jemdiggity/nami/hardware/nami-compact/exports/routing-review.pdf

## Crystal

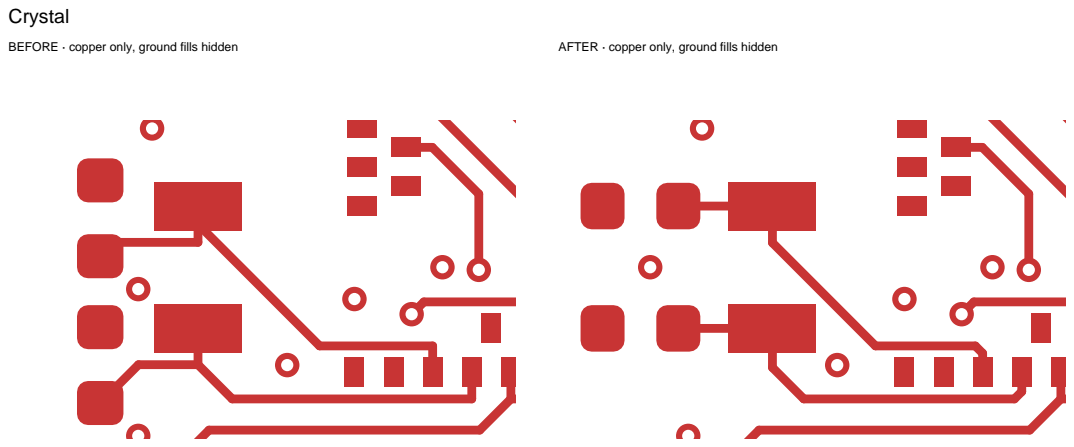
[picture p4: page 1]
BEFORE · copper only, ground fills hidden; AFTER · copper only, ground fills hidden

## Module supply

BEFORE · copper only, ground fills hidden | AFTER · copper only, ground fills hidden

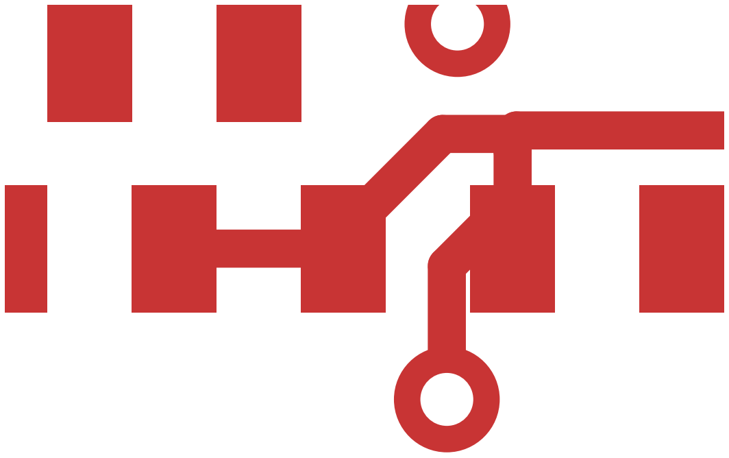
[picture p5: figure]
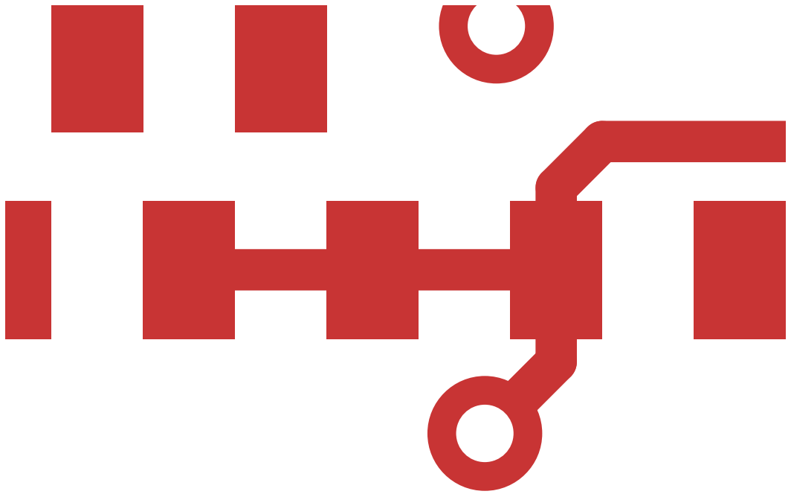
[picture p6: figure]

## CT return

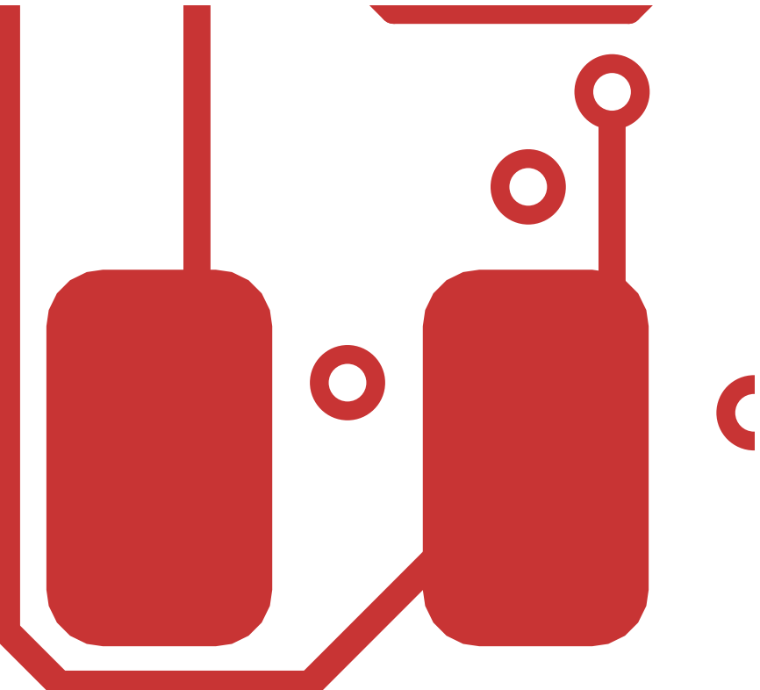
[picture p7: figure]
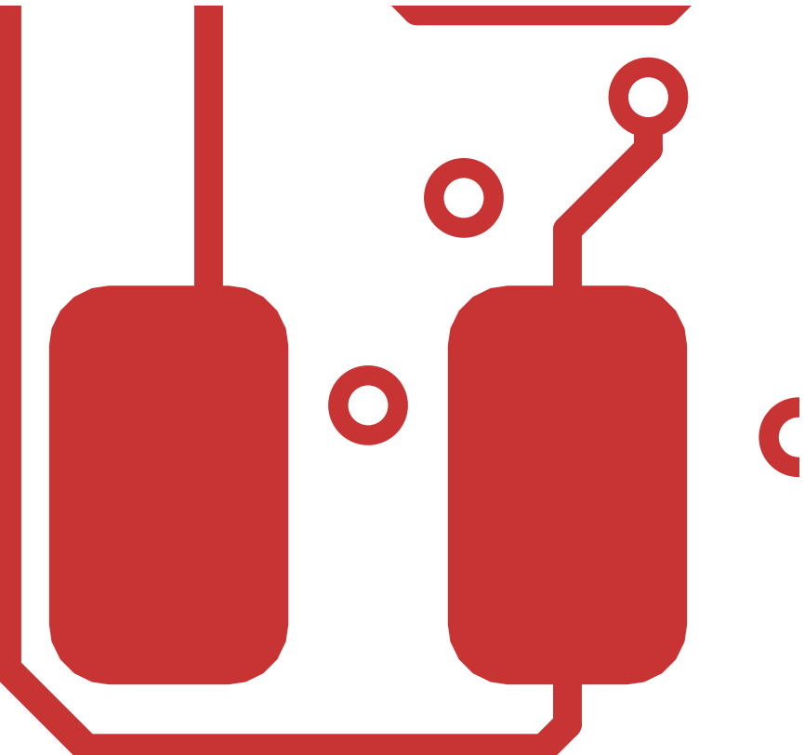
[picture p8: figure]

BEFORE · copper only, ground fills hidden | AFTER · copper only, ground fills hidden

## Module signals

BEFORE · copper only, ground fills hidden | AFTER · copper only, ground fills hidden

## Supply capacitor

BEFORE · copper only, ground fills hidden | AFTER · copper only, ground fills hidden

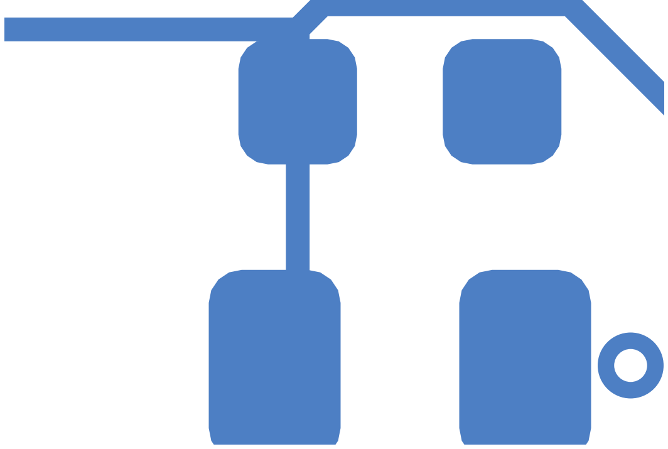
[picture p9: figure]
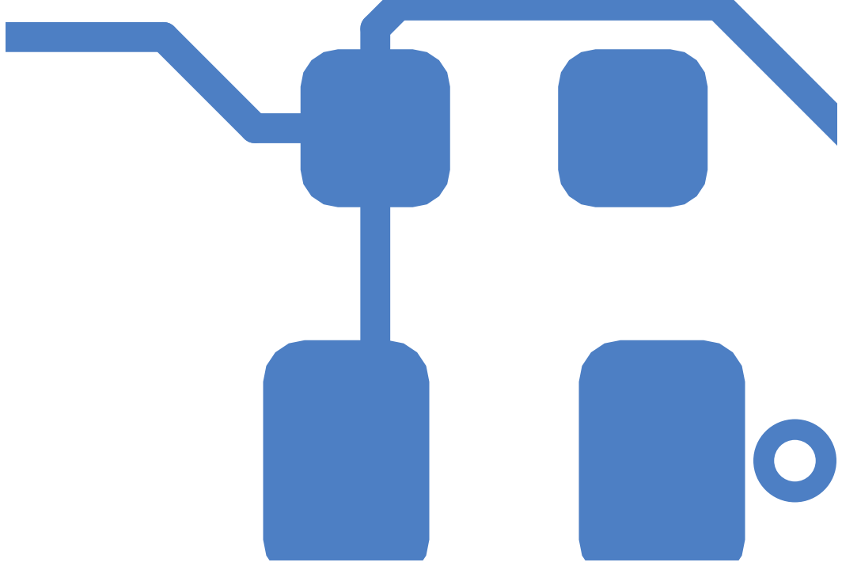
[picture p10: figure]

## Flash MOSI

BEFORE · copper only, ground fills hidden | AFTER · copper only, ground fills hidden

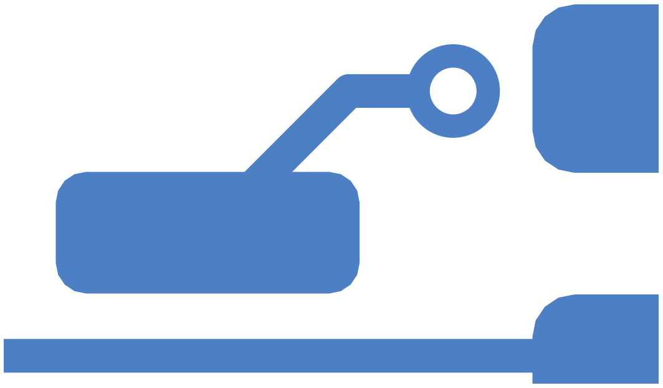
[picture p11: figure]
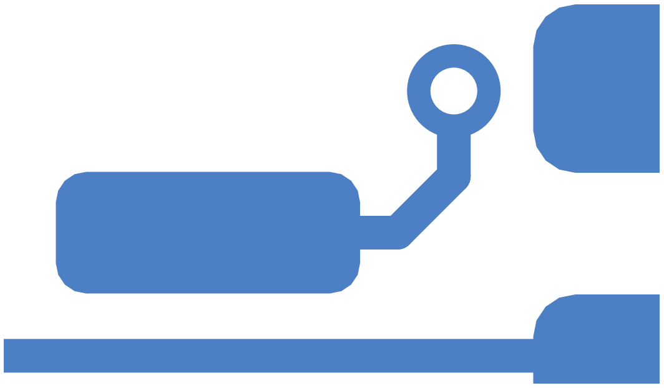
[picture p12: figure]

## Power links

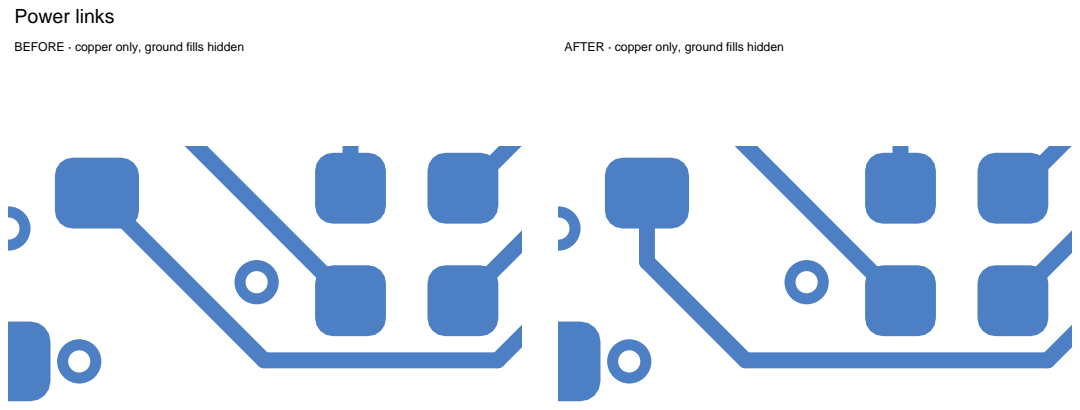
[picture p13: page 7]
BEFORE · copper only, ground fills hidden; AFTER · copper only, ground fills hidden

## Flash clock

BEFORE · copper only, ground fills hidden | AFTER · copper only, ground fills hidden

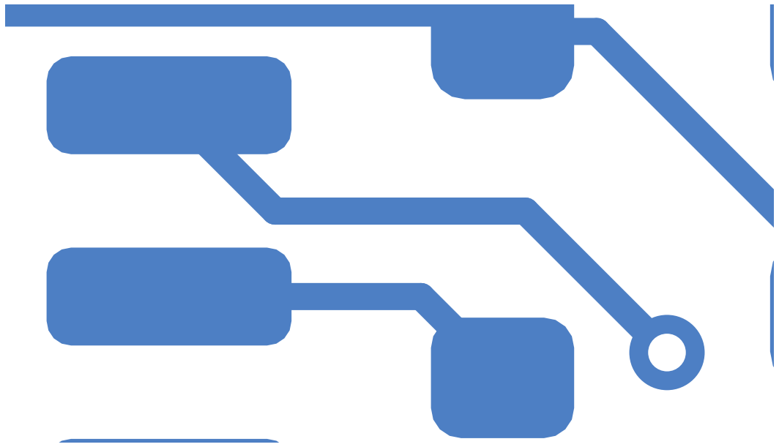
[picture p14: figure]
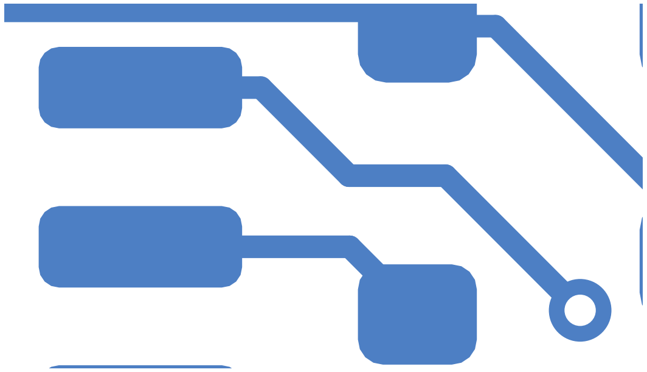
[picture p15: figure]

## Battery feed

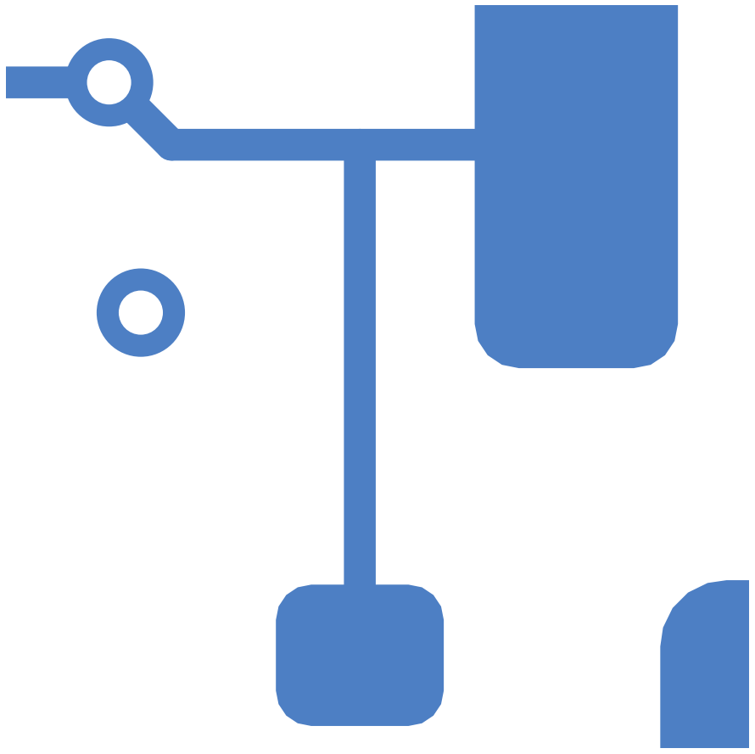
[picture p16: figure]
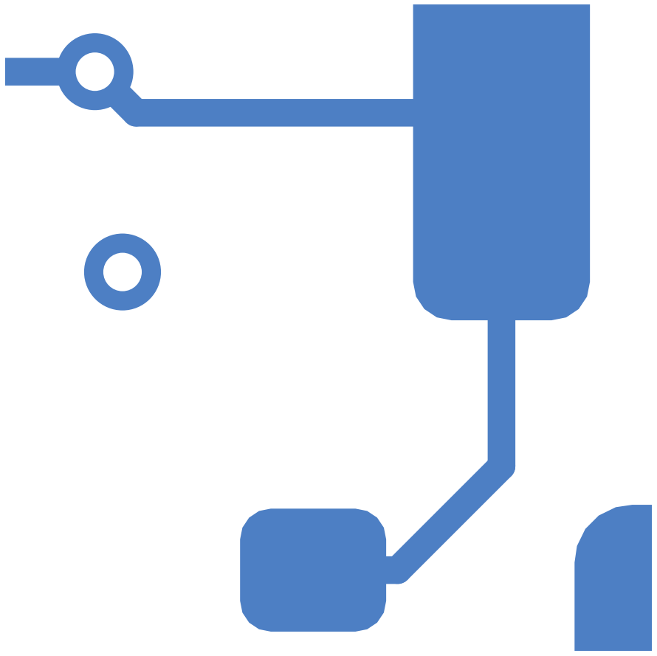
[picture p17: figure]

BEFORE · copper only, ground fills hidden | AFTER · copper only, ground fills hidden

## Power link R7

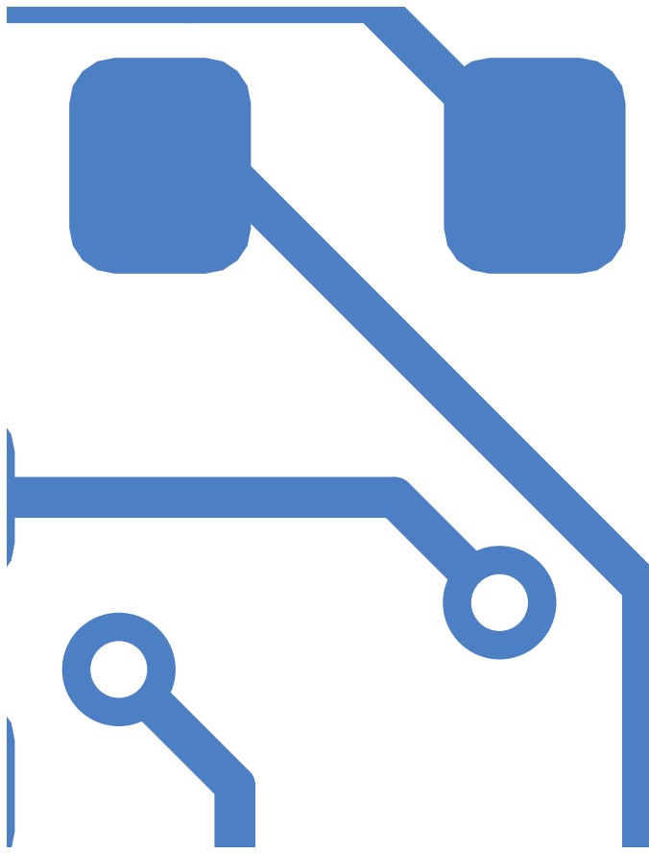
[picture p18: figure]
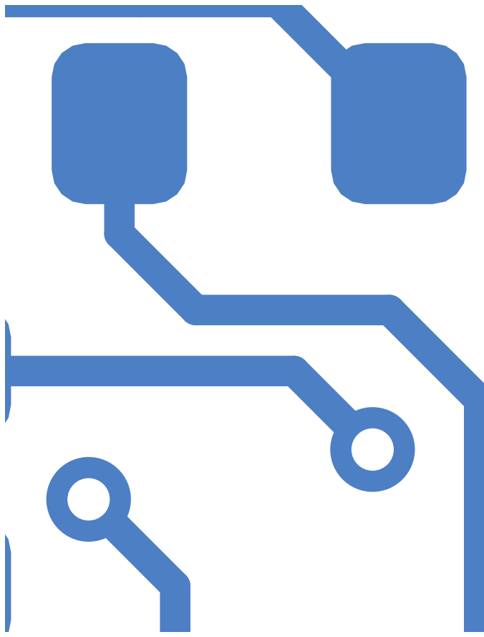
[picture p19: figure]

BEFORE · copper only, ground fills hidden | AFTER · copper only, ground fills hidden
