jemdiggity/nami/hardware/nami-rev-a/exports/nami-board.png

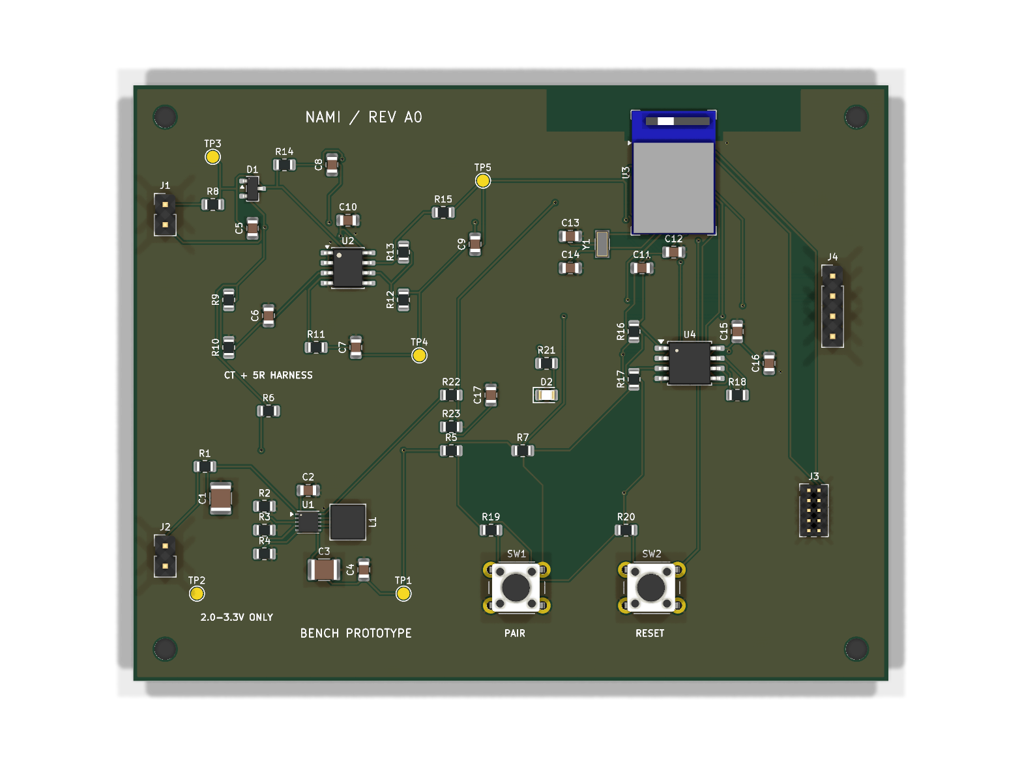
hardware/nami-rev-a/exports/nami-board.png
