jemdiggity/nami/hardware/nami-compact/exports/nami-compact.step

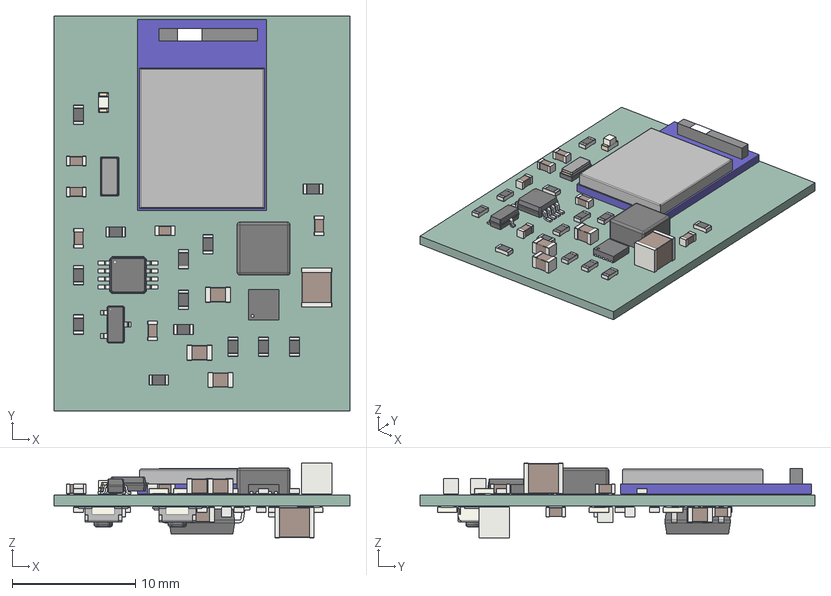
[picture p21: CAD file, 2026-09-26]
hardware/nami-compact/exports/nami-compact.step
24.0 x 32.0 x 6.08 mm
C_0603_1608Metric x 10
R_0603_1608Metric x 23
VSSOP-8_3x3mm_P0.65mm
LED_0603_1608Metric
SOT-23
C_0805_2012Metric x 5
Crystal_SMD_3215-2Pin_3.2x1.5mm
C_1210_3225Metric x 2
7a0a93aa-926b-11ed-8620-a0cec80452fd_part
7a0a9878-926b-11ed-8620-a0cec80452fd_part
7a0a9b48-926b-11ed-8620-a0cec80452fd_part
7a0a9db4-926b-11ed-8620-a0cec80452fd_part
Raytac_MDBT50Q
L_Coilcraft_XAL4020-XXX
SW_SPST_B3U-1000P x 2
SOIC-8_5.3x5.3mm_P1.27mm
nami_PCB
