jemdiggity/nami/(list of files, cad)

Other CAD files:
hardware/nami-compact/exports/nami-compact.stl
