jemdiggity/nami/hardware/nami-rev-a/exports/nami-schematic.pdf

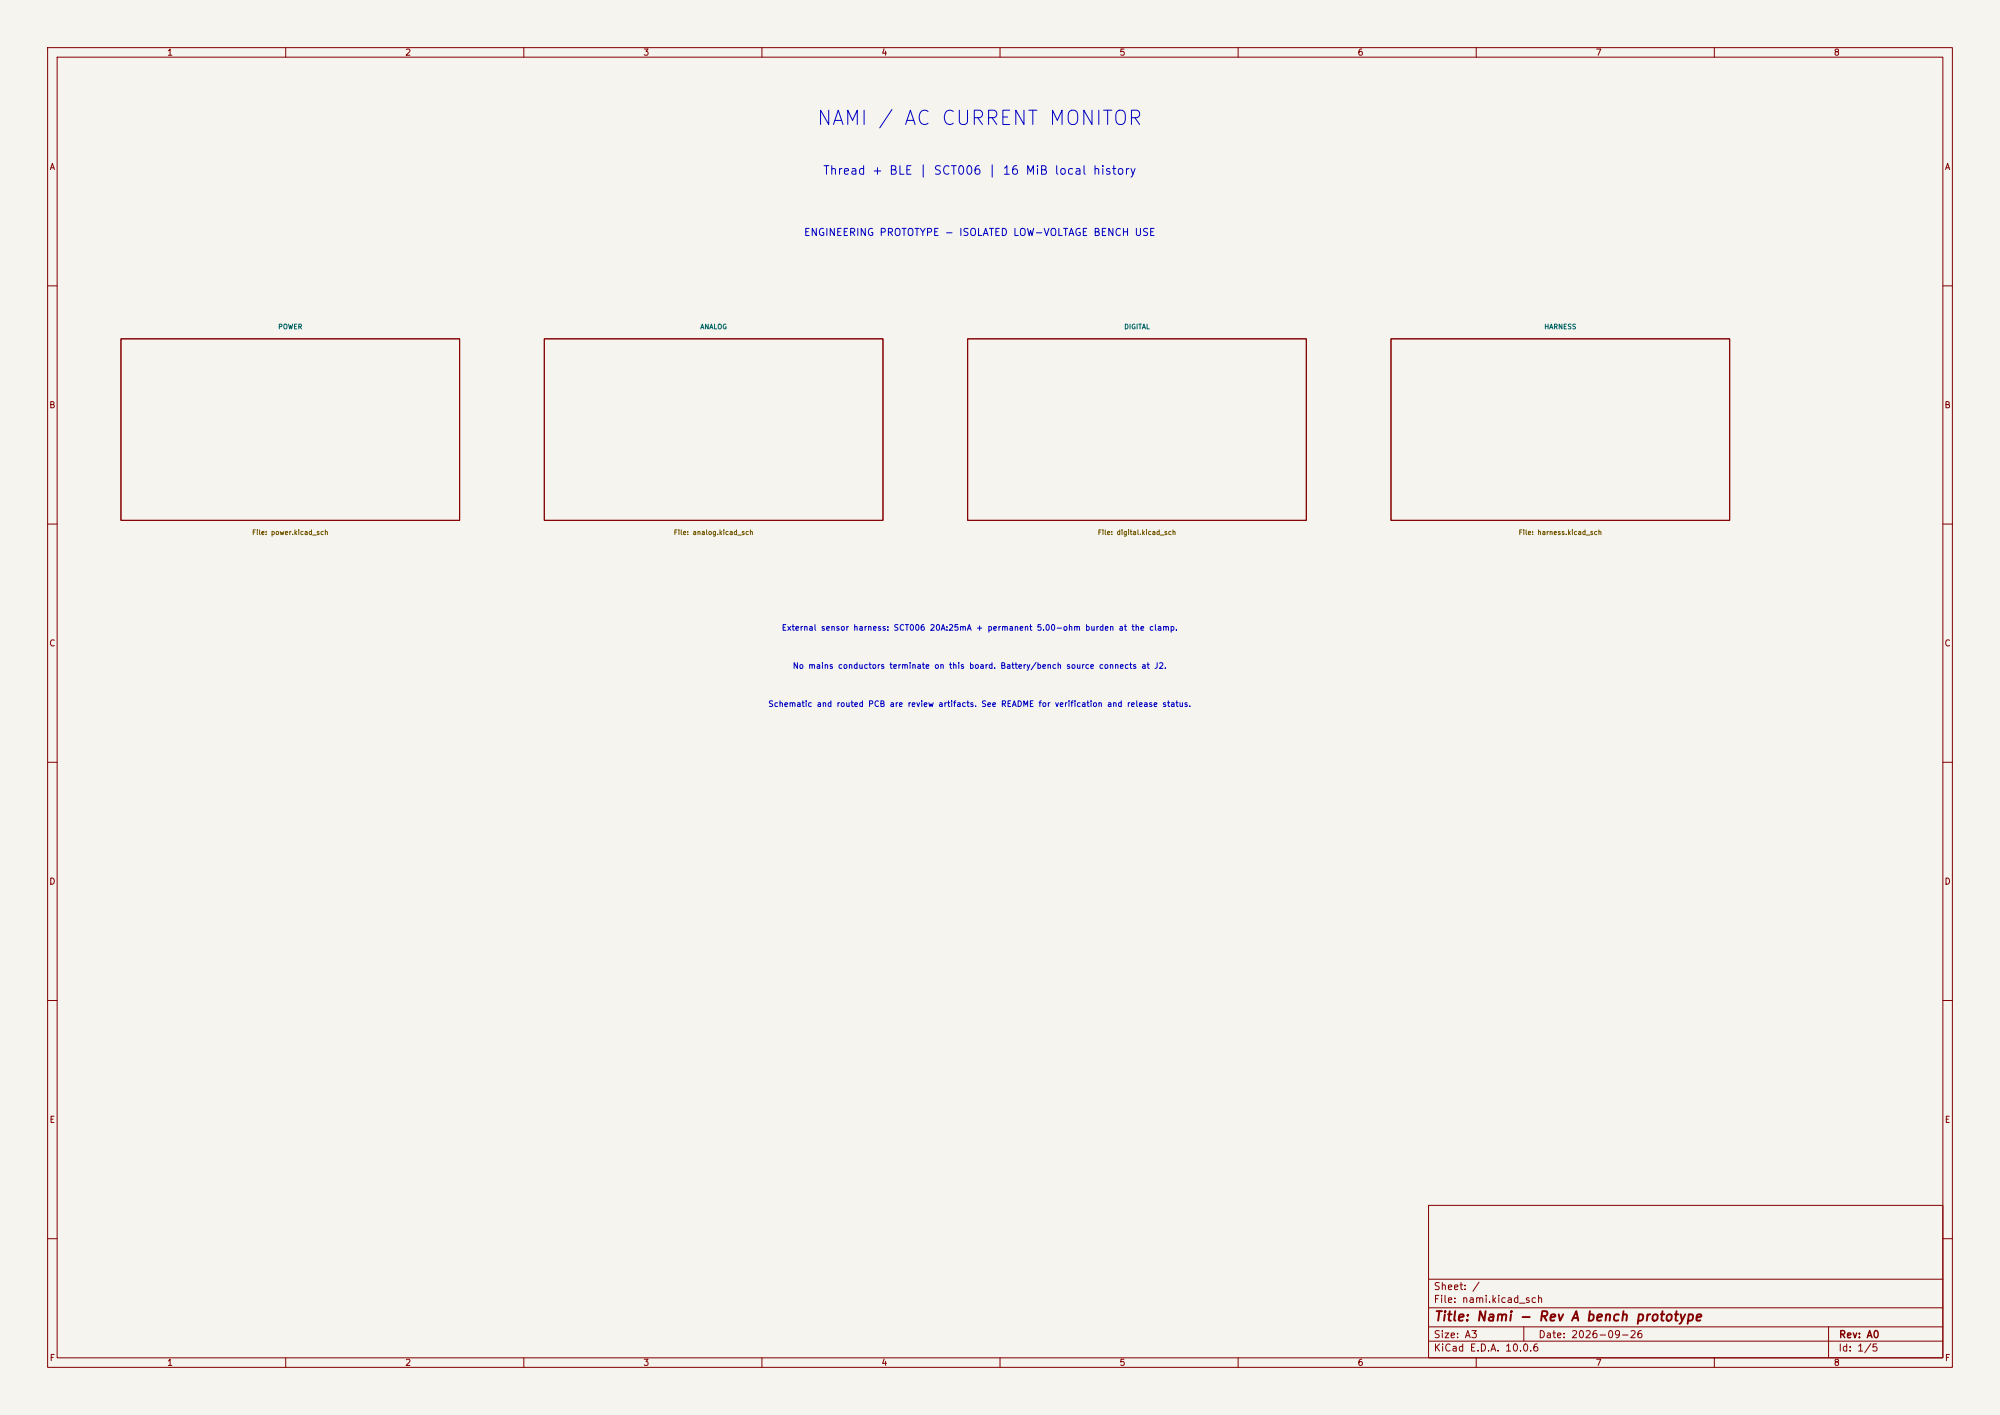
[picture p27: page 1]

File: harness.kicad_sch NAMI / AC CURRENT MONITOR

Thread + BLE | SCT006 | 16 MiB local history

ENGINEERING PROTOTYPE - ISOLATED LOW-VOLTAGE BENCH USE

External sensor harness: SCT006 20A:25mA + permanent 5.00-ohm burden at the clamp. No mains conductors terminate on this board. Battery/bench source connects at J2. Schematic and routed PCB are review artifacts. See README for verification and release status.

Sheet: /
File: nami.kicad_sch
Title: Nami - Rev A bench prototype

Size: A3 | Rev: A0 | F Date: 2026-09-26
KiCad E.D.A. 10.0.6 | Id: 1/5

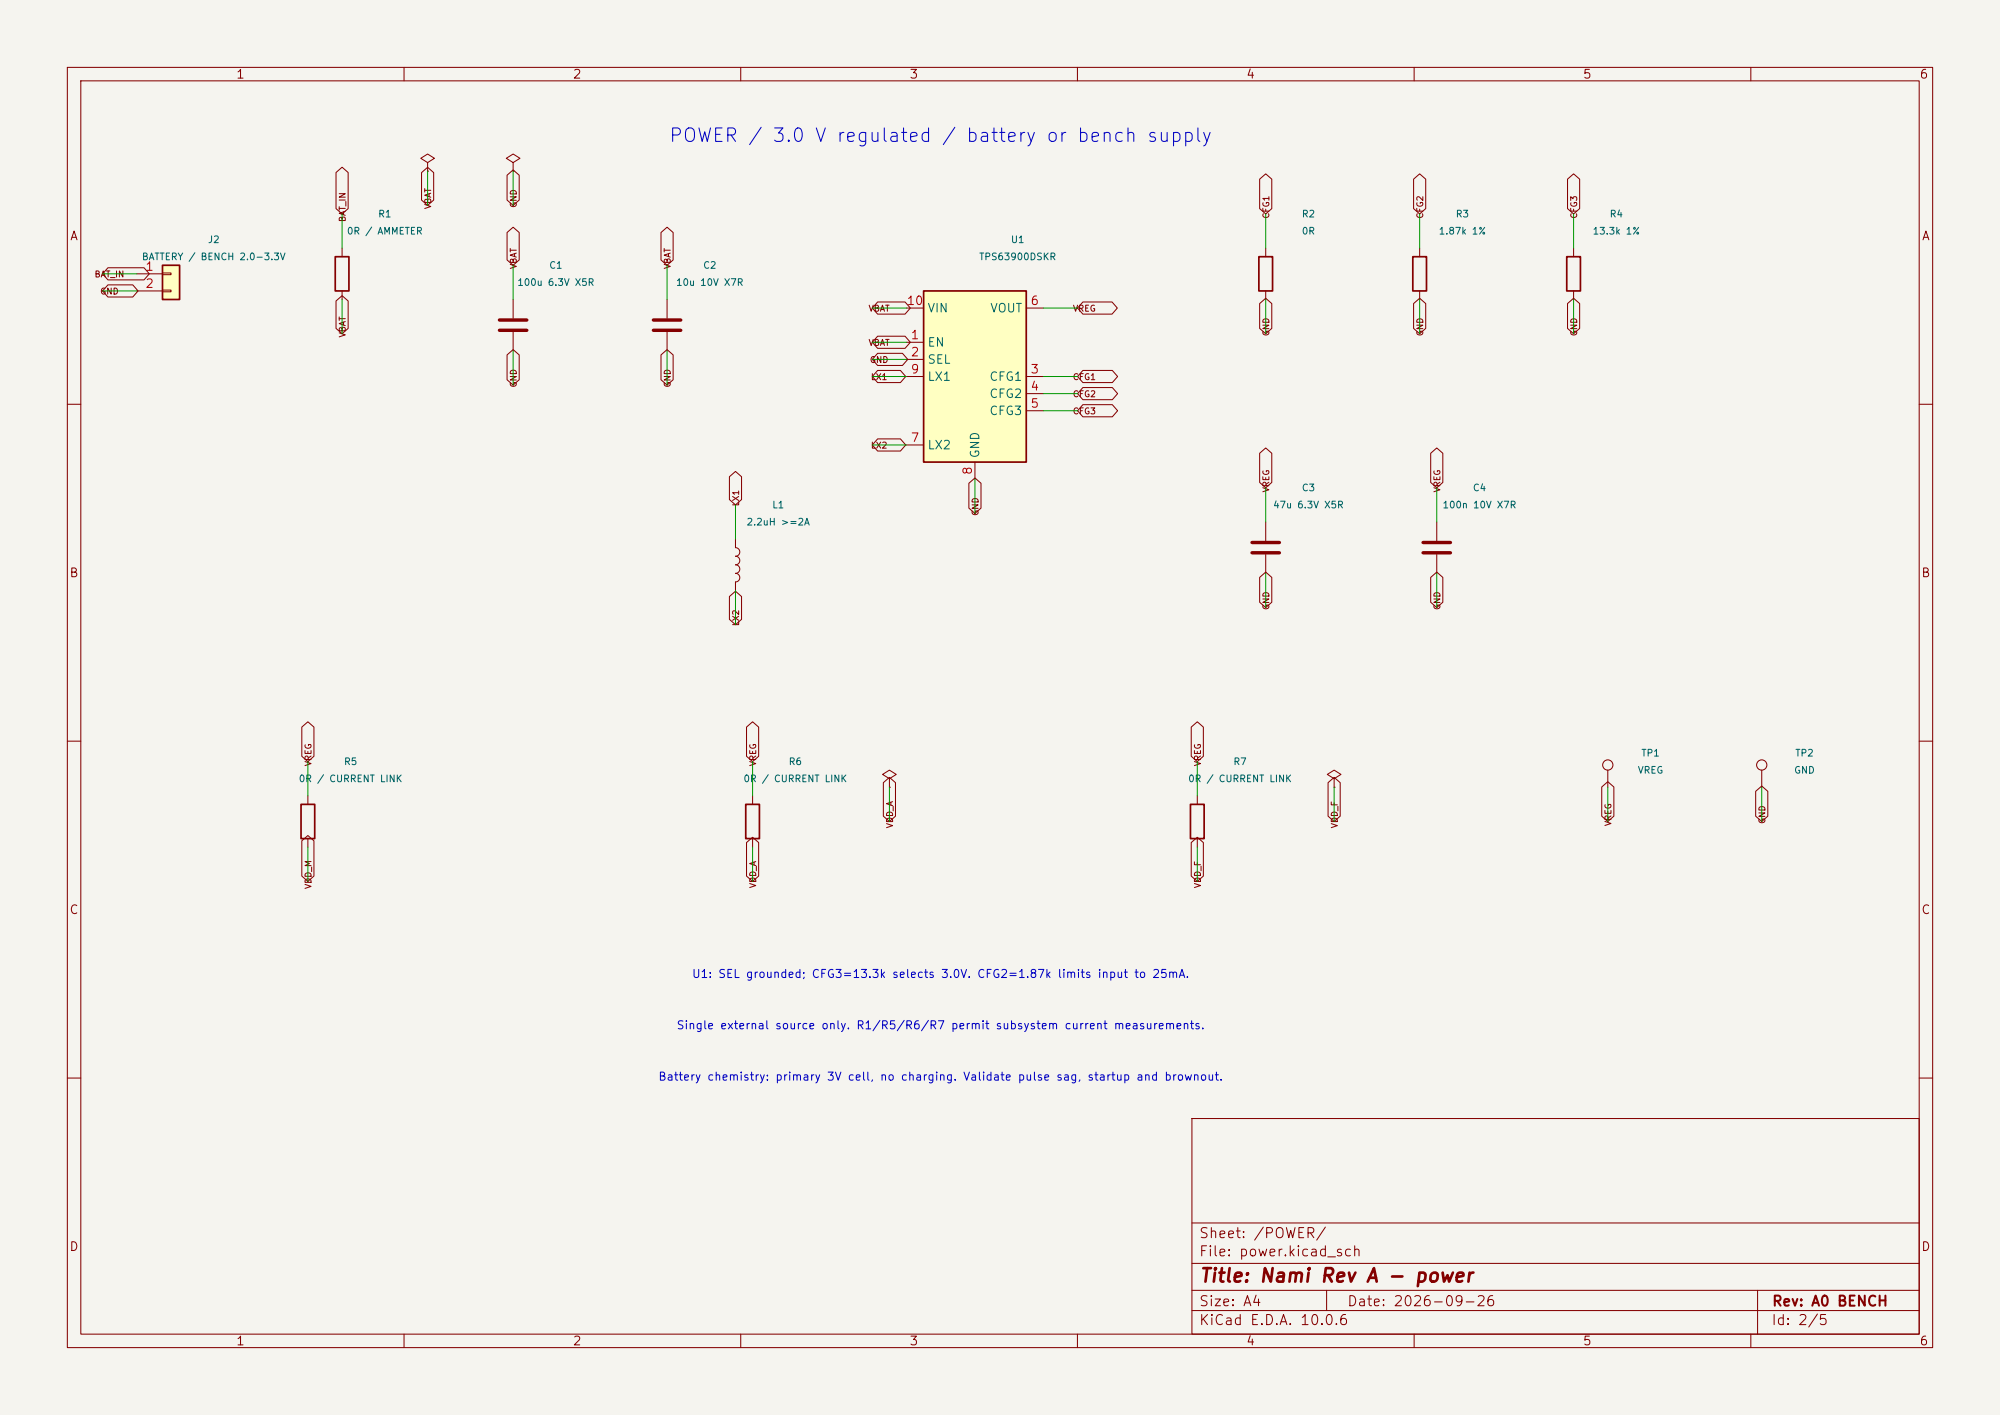
[picture p28: page 2]

POWER / 3.0 V regulated / battery or bench supply

Sheet: /POWER/
File: power.kicad_sch
Title: Nami Rev A - power

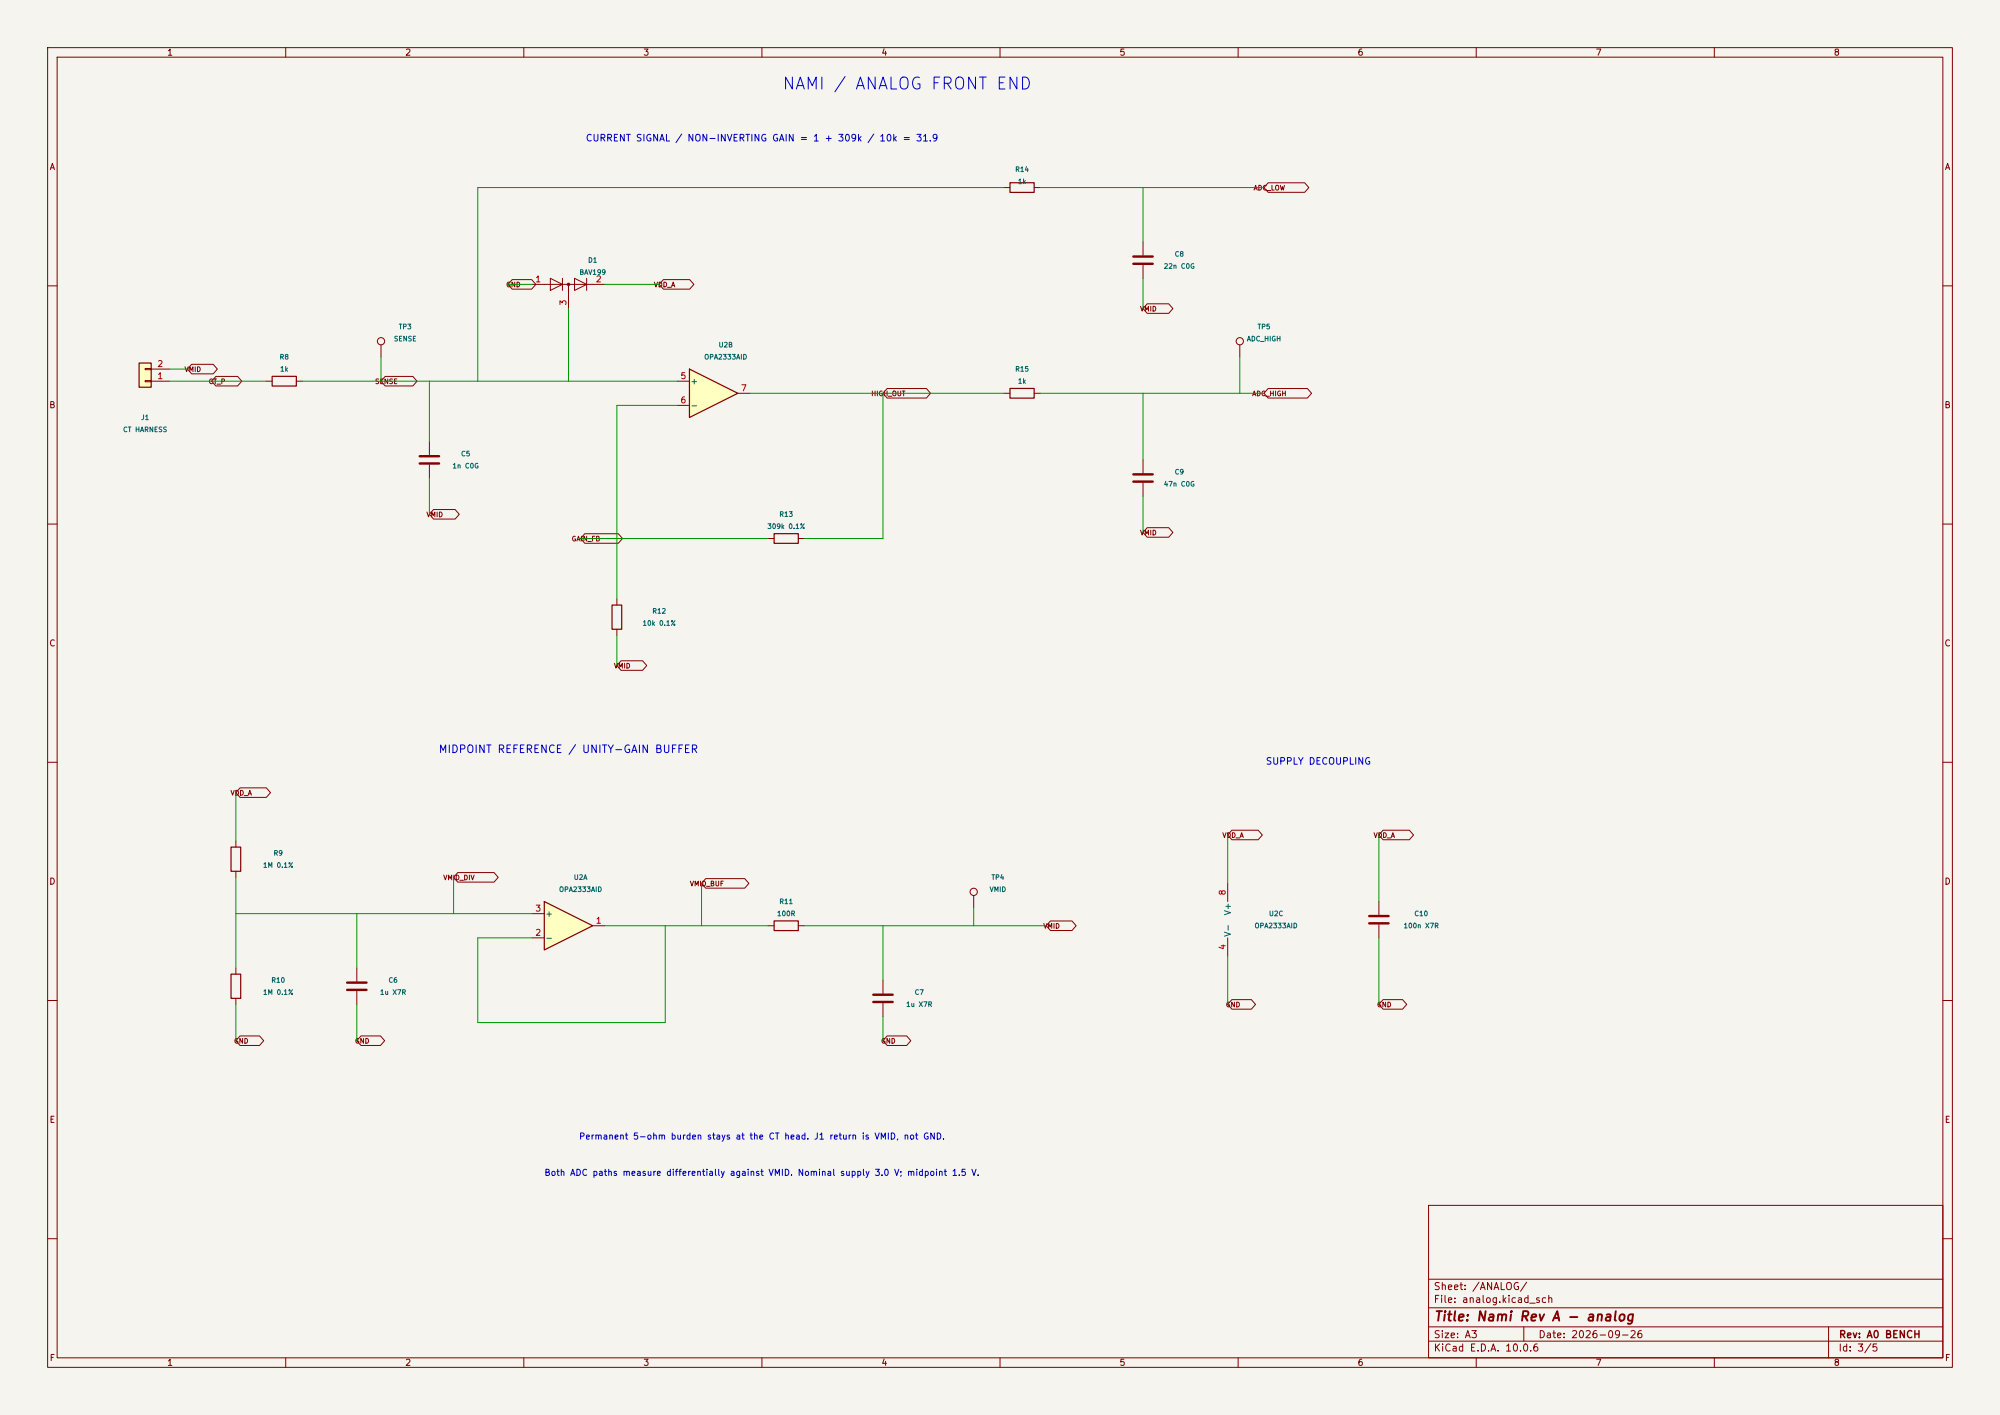
[picture p29: page 3]

VMID CURRENT SIGNAL / NON-INVERTING GAIN = 1 + 309k / 10k = 31.9 NAMI / ANALOG FRONT END
U2B OPA2333AID 1 -

Both ADC paths measure differentially against VMID. Nominal supply 3.0 V; midpoint 1.5 V. Permanent 5-ohm burden stays at the CT head. J1 return is VMID, not GND. MIDPOINT REFERENCE / UNITY-GAIN BUFFER

Sheet: /ANALOG/
File: analog.kicad_sch
Title: Nami Rev A - analog

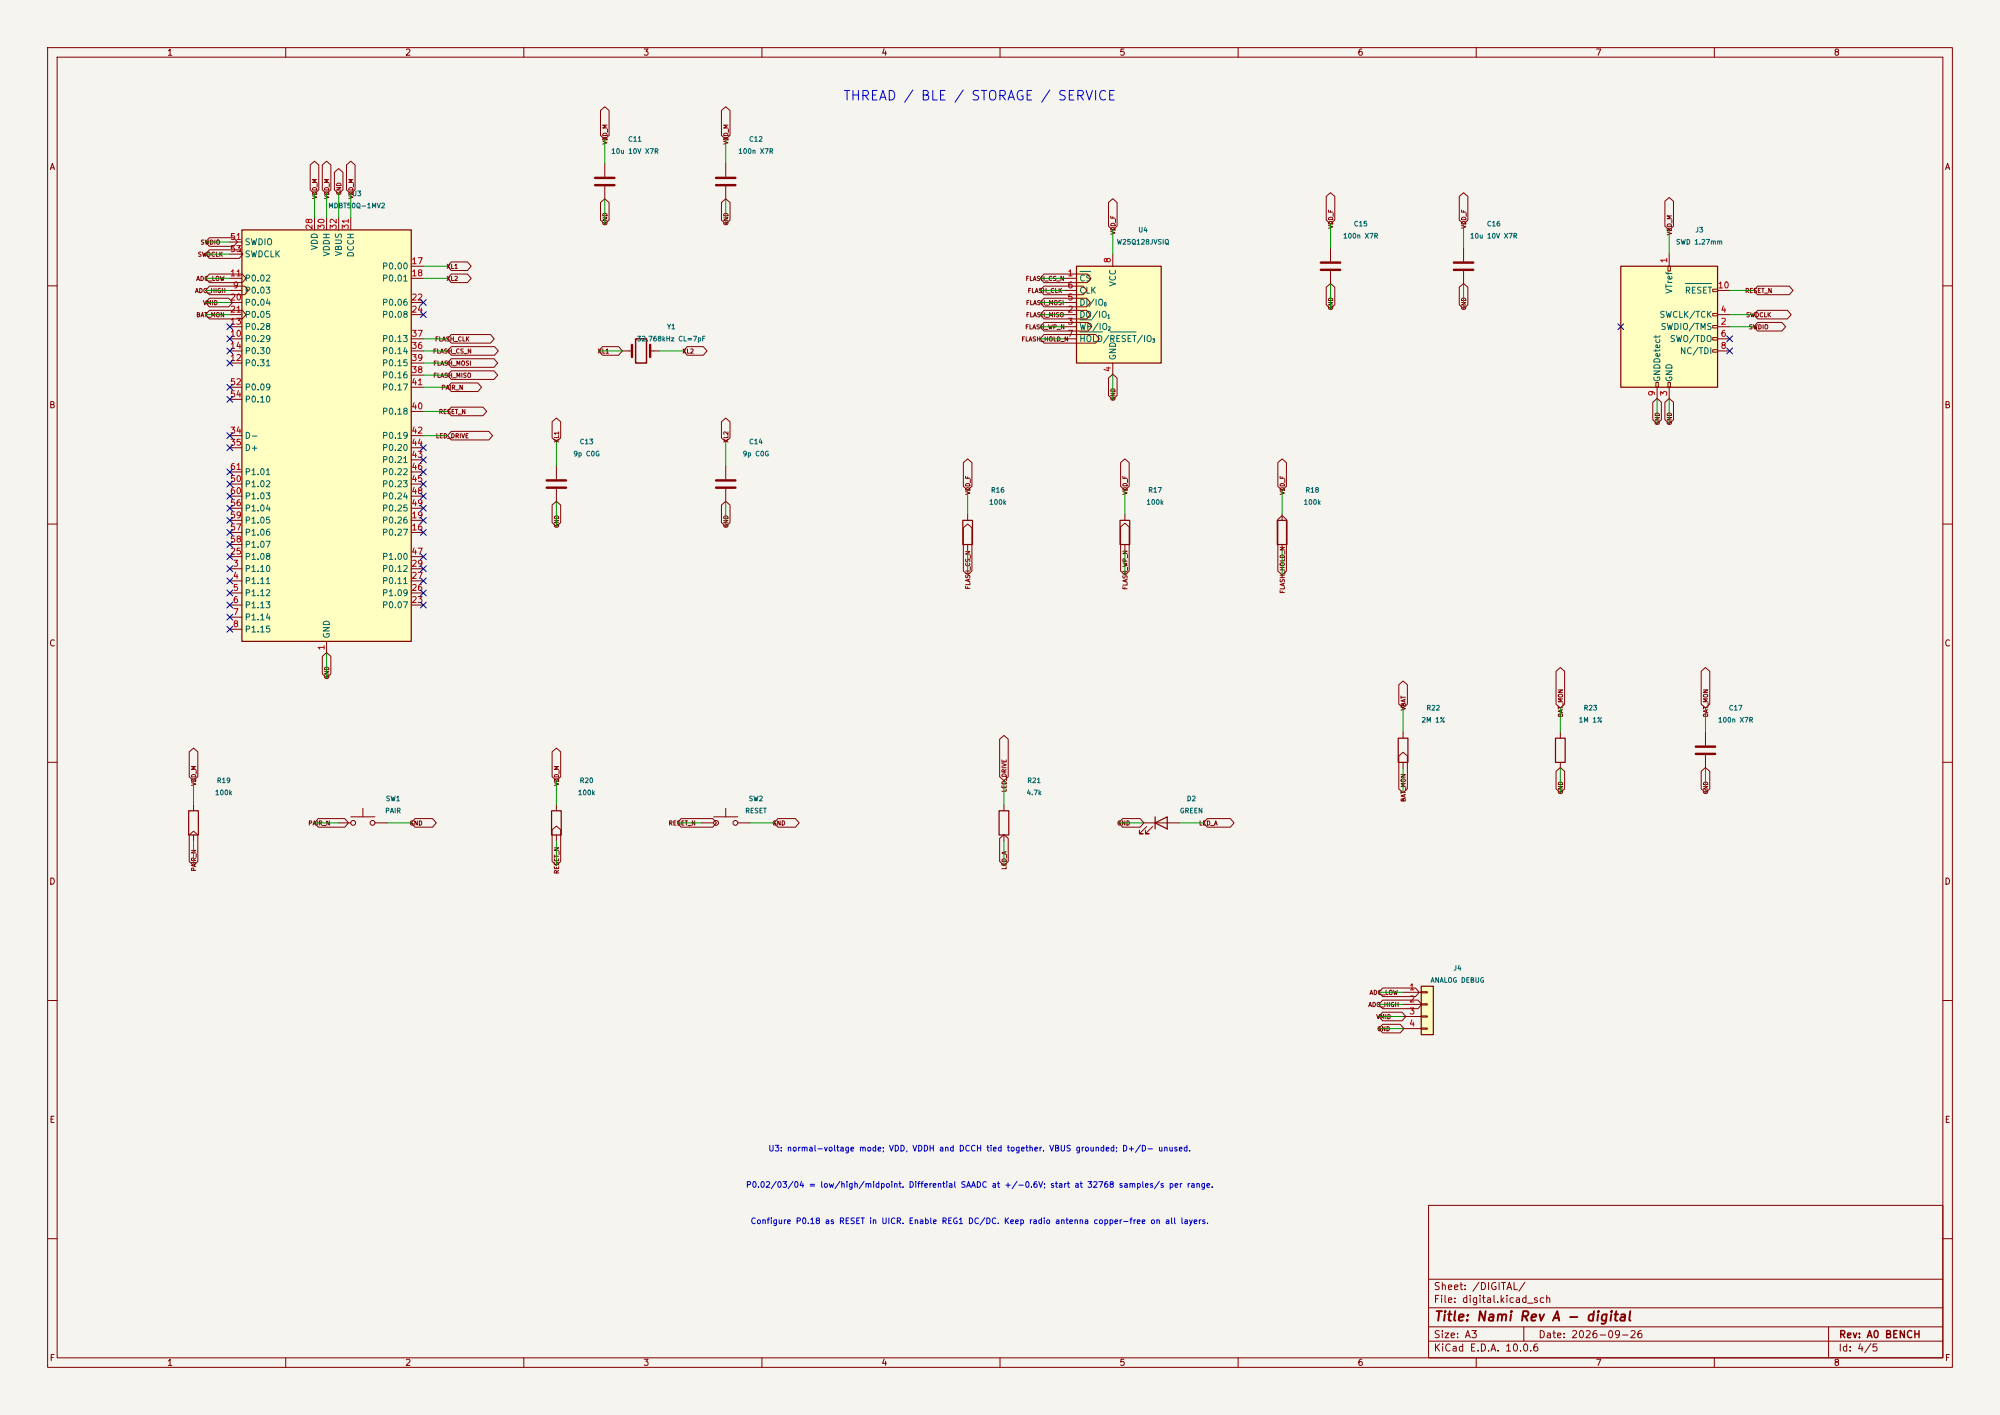
[picture p30: page 4]

THREAD / BLE / STORAGE / SERVICE

1 P1.10 3 P1.11 4 P1.12 5 P1.13 6 P1.14 7 P1.15 8 P0.03 9 P0.29 10 P0.02 11 P0.31 12 P0.28 13 P0.30 14 P0.27 16 P0.00 17 P0.01 18 P0.26 19 P0.04 20 P0.05 21 P0.06 22 P0.07 23 P0.08 24 P1.08 25 P1.09 26 P0.11 27 VDD 28 P0.12 29 VDDH 30 DCCH 31 VBUS 32 D- 34 D+ 35 P0.14 36 P0.13 37 P0.16 38 P0.15 39 P0.18 40 P0.17 41 P0.19 42 P0.21 43 P0.20 44 P0.23 45 P0.22 46 P1.00 47 P0.24 48 P0.25 49 P1.02 50

4 DI/IO0 5 CLK 6 HOLD/RESET/IO3 7 VCC

P0.02/03/04 = low/high/midpoint. Differential SAADC at +/-0.6V; start at 32768 samples/s per range.

Sheet: /DIGITAL/
File: digital.kicad_sch
Title: Nami Rev A - digital

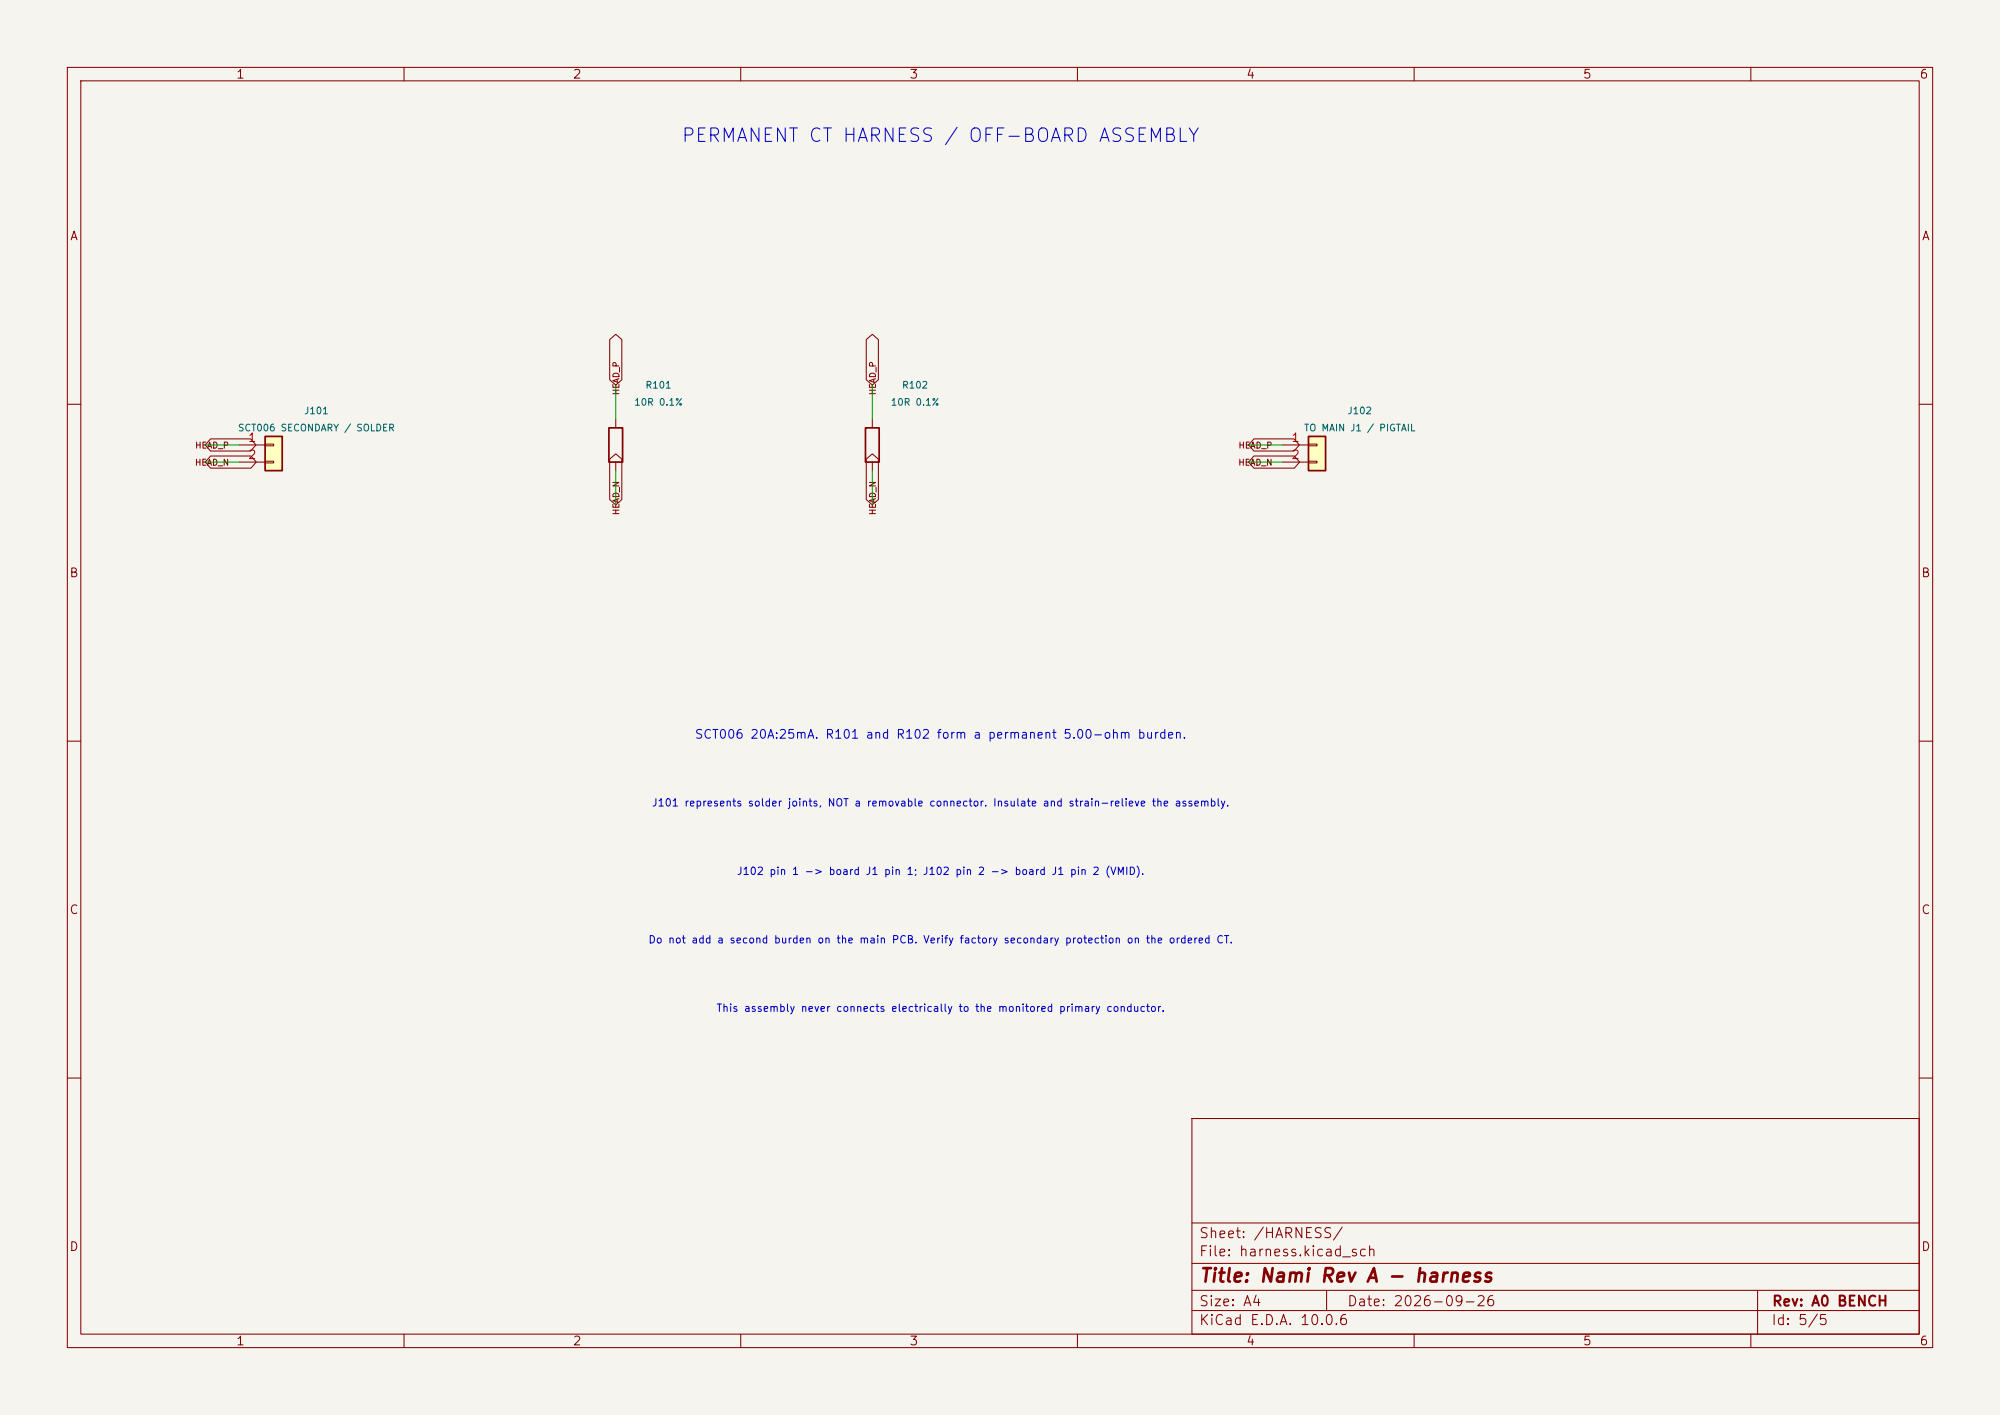
[picture p31: page 5]

This assembly never connects electrically to the monitored primary conductor. Do not add a second burden on the main PCB. Verify factory secondary protection on the ordered CT. J102 pin 1 -> board J1 pin 1; J102 pin 2 -> board J1 pin 2 (VMID). J101 represents solder joints, NOT a removable connector. Insulate and strain-relieve the assembly. SCT006 20A:25mA. R101 and R102 form a permanent 5.00-ohm burden.

Sheet: /HARNESS/
File: harness.kicad_sch
Title: Nami Rev A - harness
