jemdiggity/nami/hardware/nami-compact/nami.kicad_pcb

## KiCad design hardware/nami-compact/nami.kicad_pcb (2026-09-26)

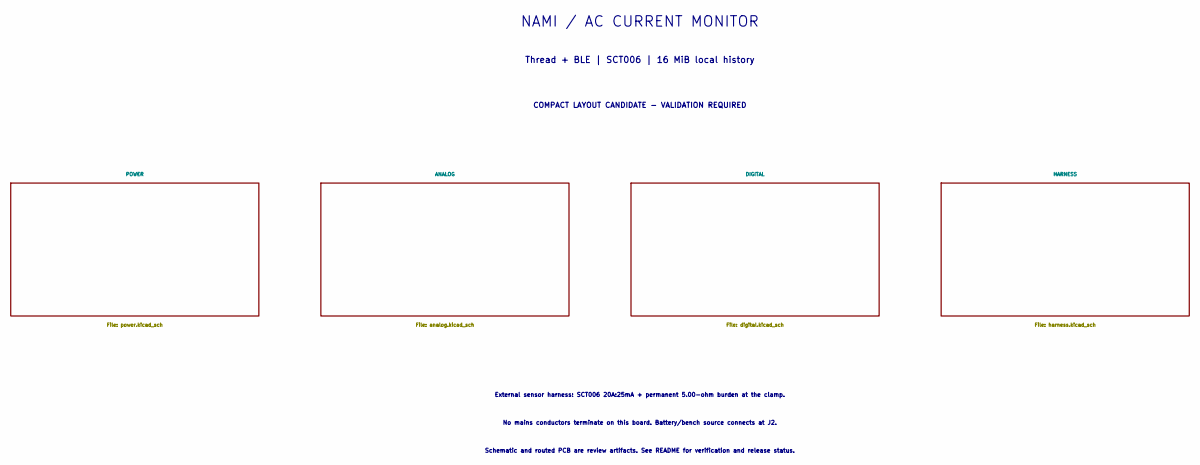
[picture p32: schematic nami.kicad_sch, Nami Compact C0]

Notes on the sheet:
NAMI / AC CURRENT MONITOR
Thread + BLE | SCT006 | 16 MiB local history
COMPACT LAYOUT CANDIDATE - VALIDATION REQUIRED
External sensor harness: SCT006 20A:25mA + permanent 5.00-ohm burden at the clamp.
No mains conductors terminate on this board. Battery/bench source connects at J2.
Schematic and routed PCB are review artifacts. See README for verification and release status.

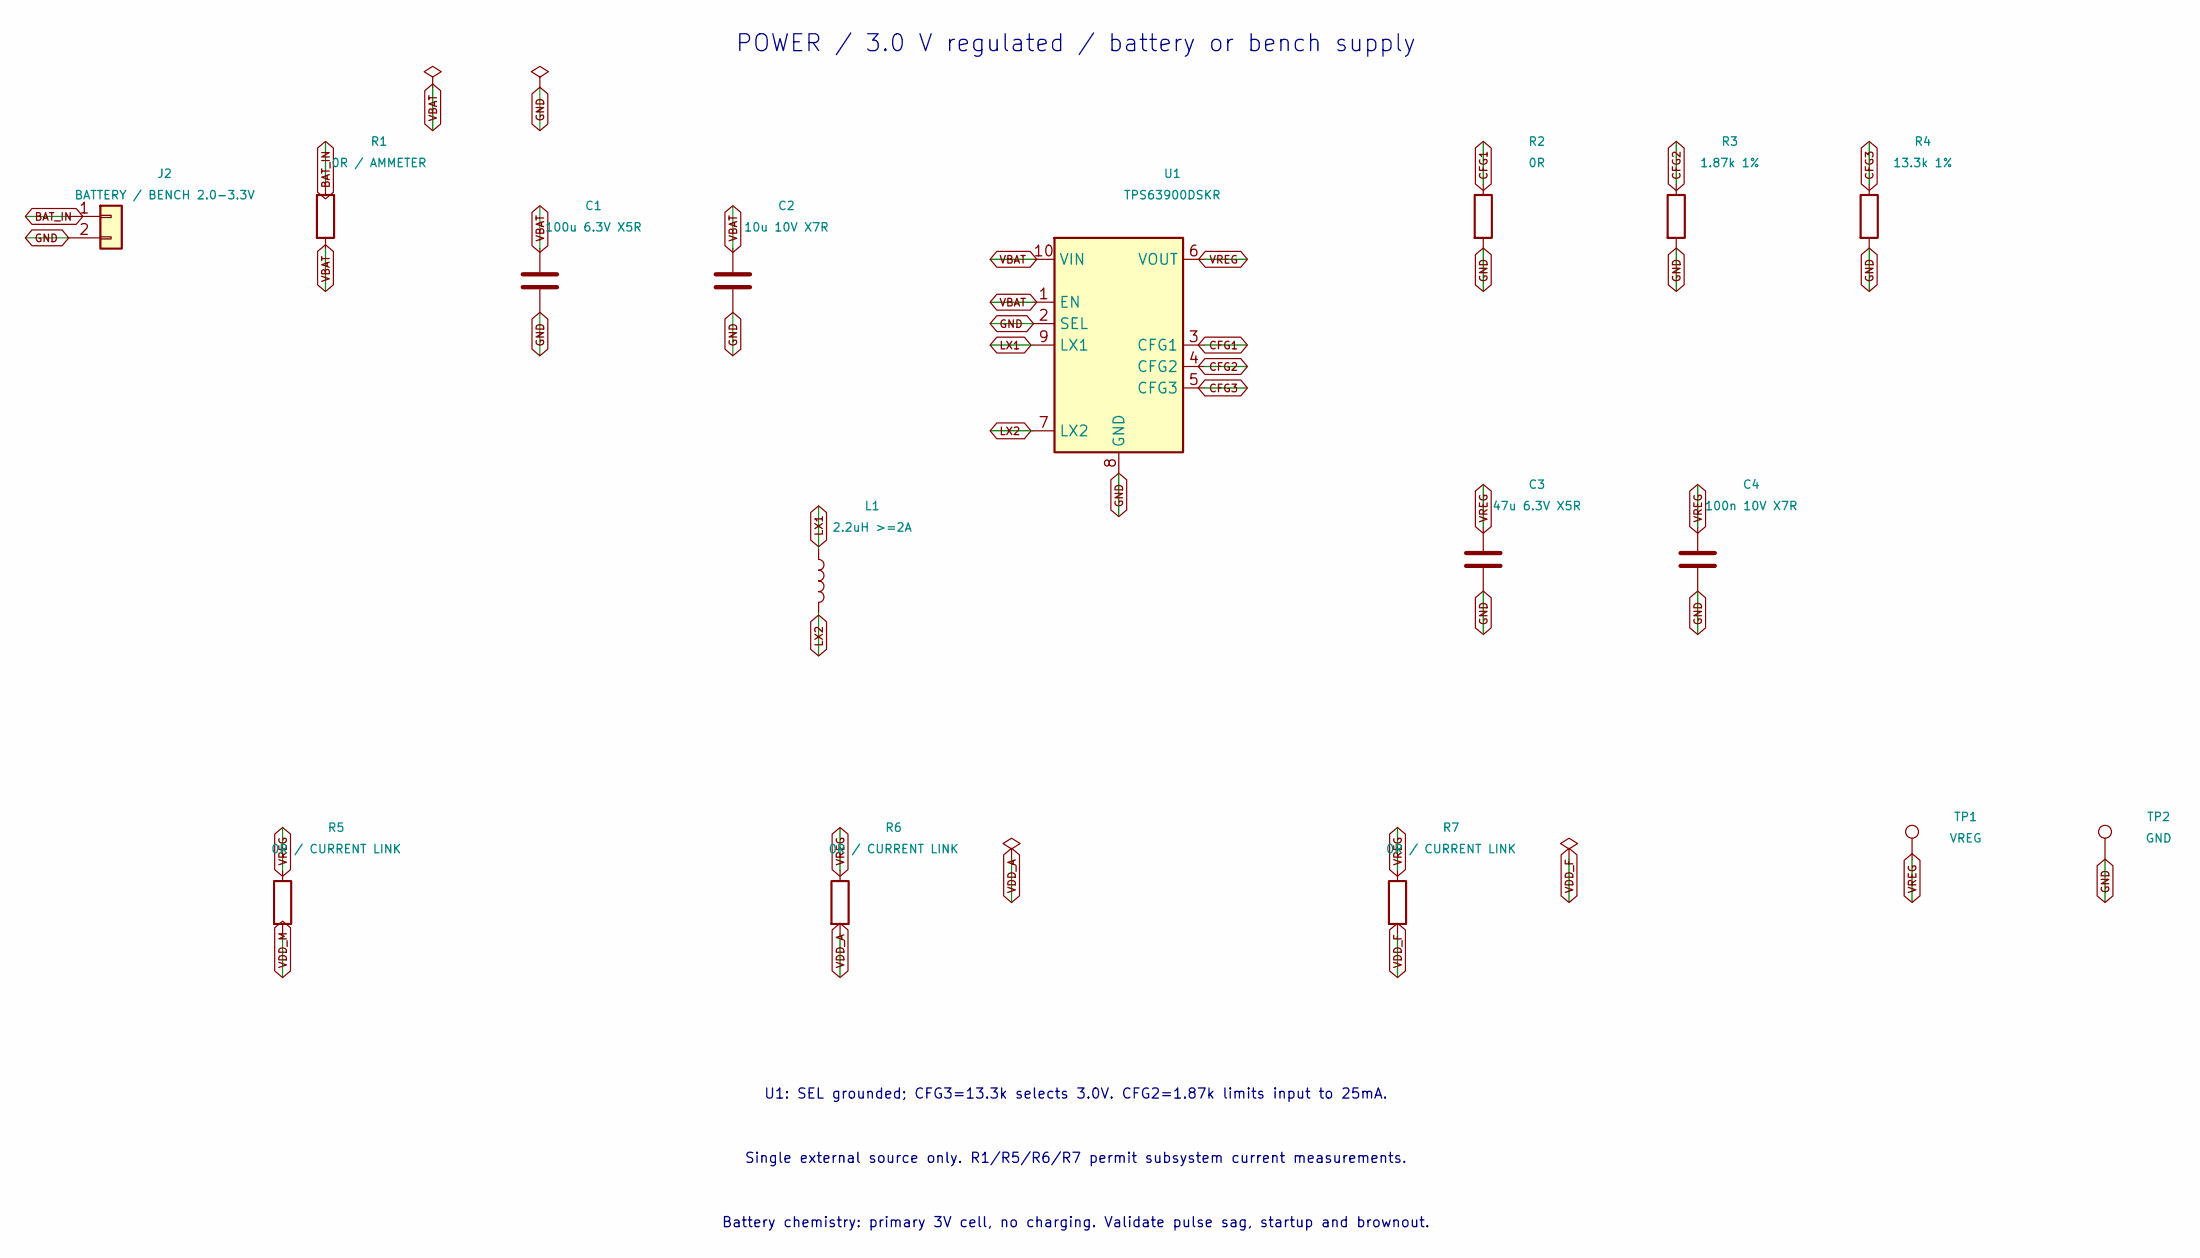
[picture p33: schematic power.kicad_sch, Nami Compact C0 - power]

Parts:
C1: 100u 6.3V X5R; C_1210_3225Metric; MPN GRM32ER60J107ME20L
C2: 10u 10V X7R; C_0805_2012Metric
C3: 47u 6.3V X5R; C_1210_3225Metric
C4: 100n 10V X7R; C_0603_1608Metric
J2: BATTERY / BENCH 2.0-3.3V; WirePads_2_P2.5
L1: 2.2uH >=2A; L_Coilcraft_XAL4020-XXX; MPN XAL4020-222MEC
R1: 0R / AMMETER; R_0603_1608Metric
R2: 0R; R_0603_1608Metric
R3: 1.87k 1%; R_0603_1608Metric
R4: 13.3k 1%; R_0603_1608Metric
R5, R6, R7: 0R / CURRENT LINK; R_0603_1608Metric
TP1: VREG; TestPoint_Pad_D1.0mm
TP2: GND; TestPoint_Pad_D1.0mm
U1: TPS63900DSKR; WSON-10-1EP_2.5x2.5mm_P0.5mm_EP1.2x2mm; MPN TPS63900DSKR

Connections:
BAT_IN: J2.1, R1.1
CFG1: R2.1, U1.3 (CFG1)
CFG2: R3.1, U1.4 (CFG2)
CFG3: R4.1, U1.5 (CFG3)
GND: C1.2, C2.2, C3.2, C4.2, J2.2, R2.2, R3.2, R4.2, TP2.1, U1.2 (SEL), U1.8 (GND), U1.11 (GND); also elsewhere on the board
LX1: L1.1, U1.9 (LX1)
LX2: L1.2, U1.7 (LX2)
VBAT: C1.1, C2.1, R1.2, U1.1 (EN), U1.10 (VIN); also elsewhere on the board
VDD_A: R6.2; also elsewhere on the board
VDD_F: R7.2; also elsewhere on the board
VDD_M: R5.2; also elsewhere on the board
VREG: C3.1, C4.1, R5.1, R6.1, R7.1, TP1.1, U1.6 (VOUT)

Notes on the sheet:
POWER / 3.0 V regulated / battery or bench supply
U1: SEL grounded; CFG3=13.3k selects 3.0V. CFG2=1.87k limits input to 25mA.
Single external source only. R1/R5/R6/R7 permit subsystem current measurements.
Battery chemistry: primary 3V cell, no charging. Validate pulse sag, startup and brownout.

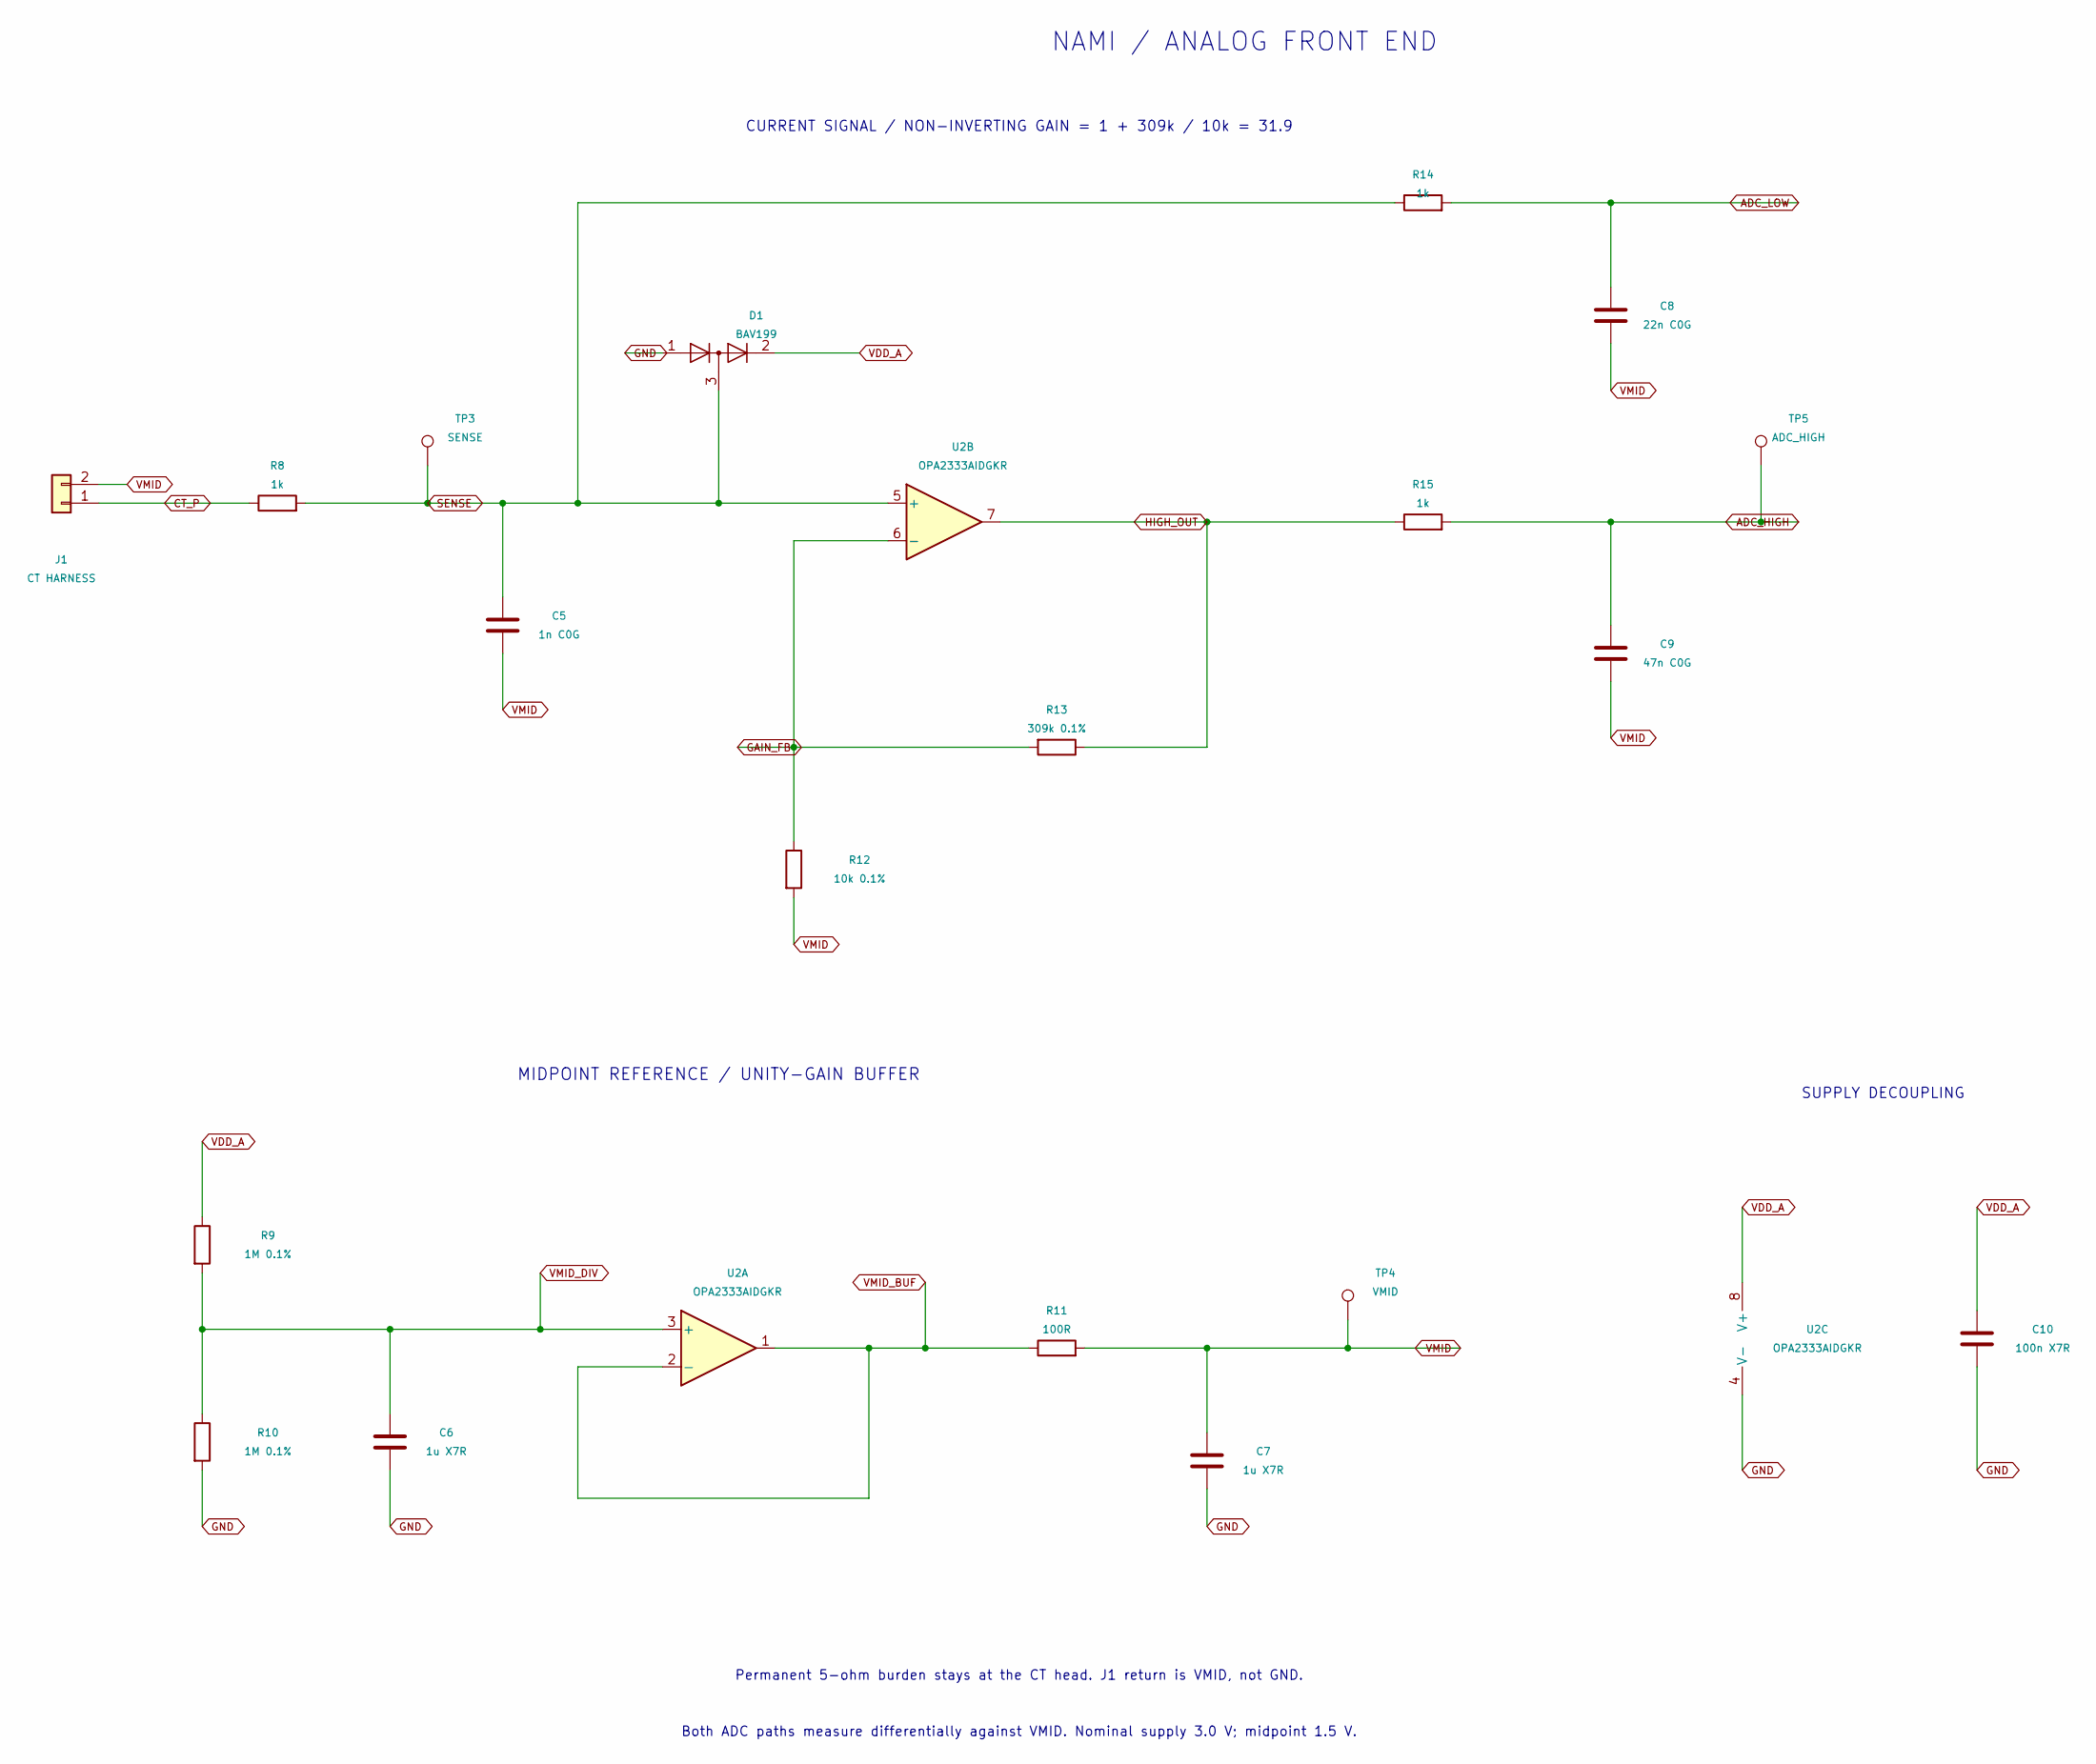
[picture p34: schematic analog.kicad_sch, Nami Compact C0 - analog]

Parts:
C5: 1n C0G; C_0603_1608Metric
C6, C7: 1u X7R; C_0603_1608Metric
C8: 22n C0G; C_0805_2012Metric
C9: 47n C0G; C_0805_2012Metric
C10: 100n X7R; C_0603_1608Metric
D1: BAV199; SOT-23; MPN BAV199,215
J1: CT HARNESS; WirePads_2_P2.5
R8, R14, R15: 1k; R_0603_1608Metric
R9, R10: 1M 0.1%; R_0603_1608Metric
R11: 100R; R_0603_1608Metric
R12: 10k 0.1%; R_0603_1608Metric
R13: 309k 0.1%; R_0603_1608Metric
TP3: SENSE; TestPoint_Pad_D1.0mm
TP4: VMID; TestPoint_Pad_D1.0mm
TP5: ADC_HIGH; TestPoint_Pad_D1.0mm
U2: OPA2333AIDGKR; VSSOP-8_3x3mm_P0.65mm; MPN OPA2333AIDGKR

Connections:
ADC_HIGH: C9.1, R15.2, TP5.1; also elsewhere on the board
ADC_LOW: C8.1, R14.2; also elsewhere on the board
CT_P: J1.1, R8.1
GAIN_FB: R12.1, R13.2, U2.6 (-)
GND: C6.2, C7.2, C10.2, D1.1 (K), R10.2, U2.4 (V-); also elsewhere on the board
HIGH_OUT: R13.1, R15.1, U2.7
SENSE: C5.1, D1.3 (K), R8.2, R14.1, TP3.1, U2.5 (+)
VDD_A: C10.1, D1.2 (A), R9.1, U2.8 (V+); also elsewhere on the board
VMID: C5.2, C7.1, C8.2, C9.2, J1.2, R11.2, R12.2, TP4.1; also elsewhere on the board
VMID_BUF: R11.1, U2.1, U2.2 (-)
VMID_DIV: C6.1, R9.2, R10.1, U2.3 (+)

Notes on the sheet:
NAMI / ANALOG FRONT END
CURRENT SIGNAL / NON-INVERTING GAIN = 1 + 309k / 10k = 31.9
MIDPOINT REFERENCE / UNITY-GAIN BUFFER
SUPPLY DECOUPLING
Permanent 5-ohm burden stays at the CT head. J1 return is VMID, not GND.
Both ADC paths measure differentially against VMID. Nominal supply 3.0 V; midpoint 1.5 V.

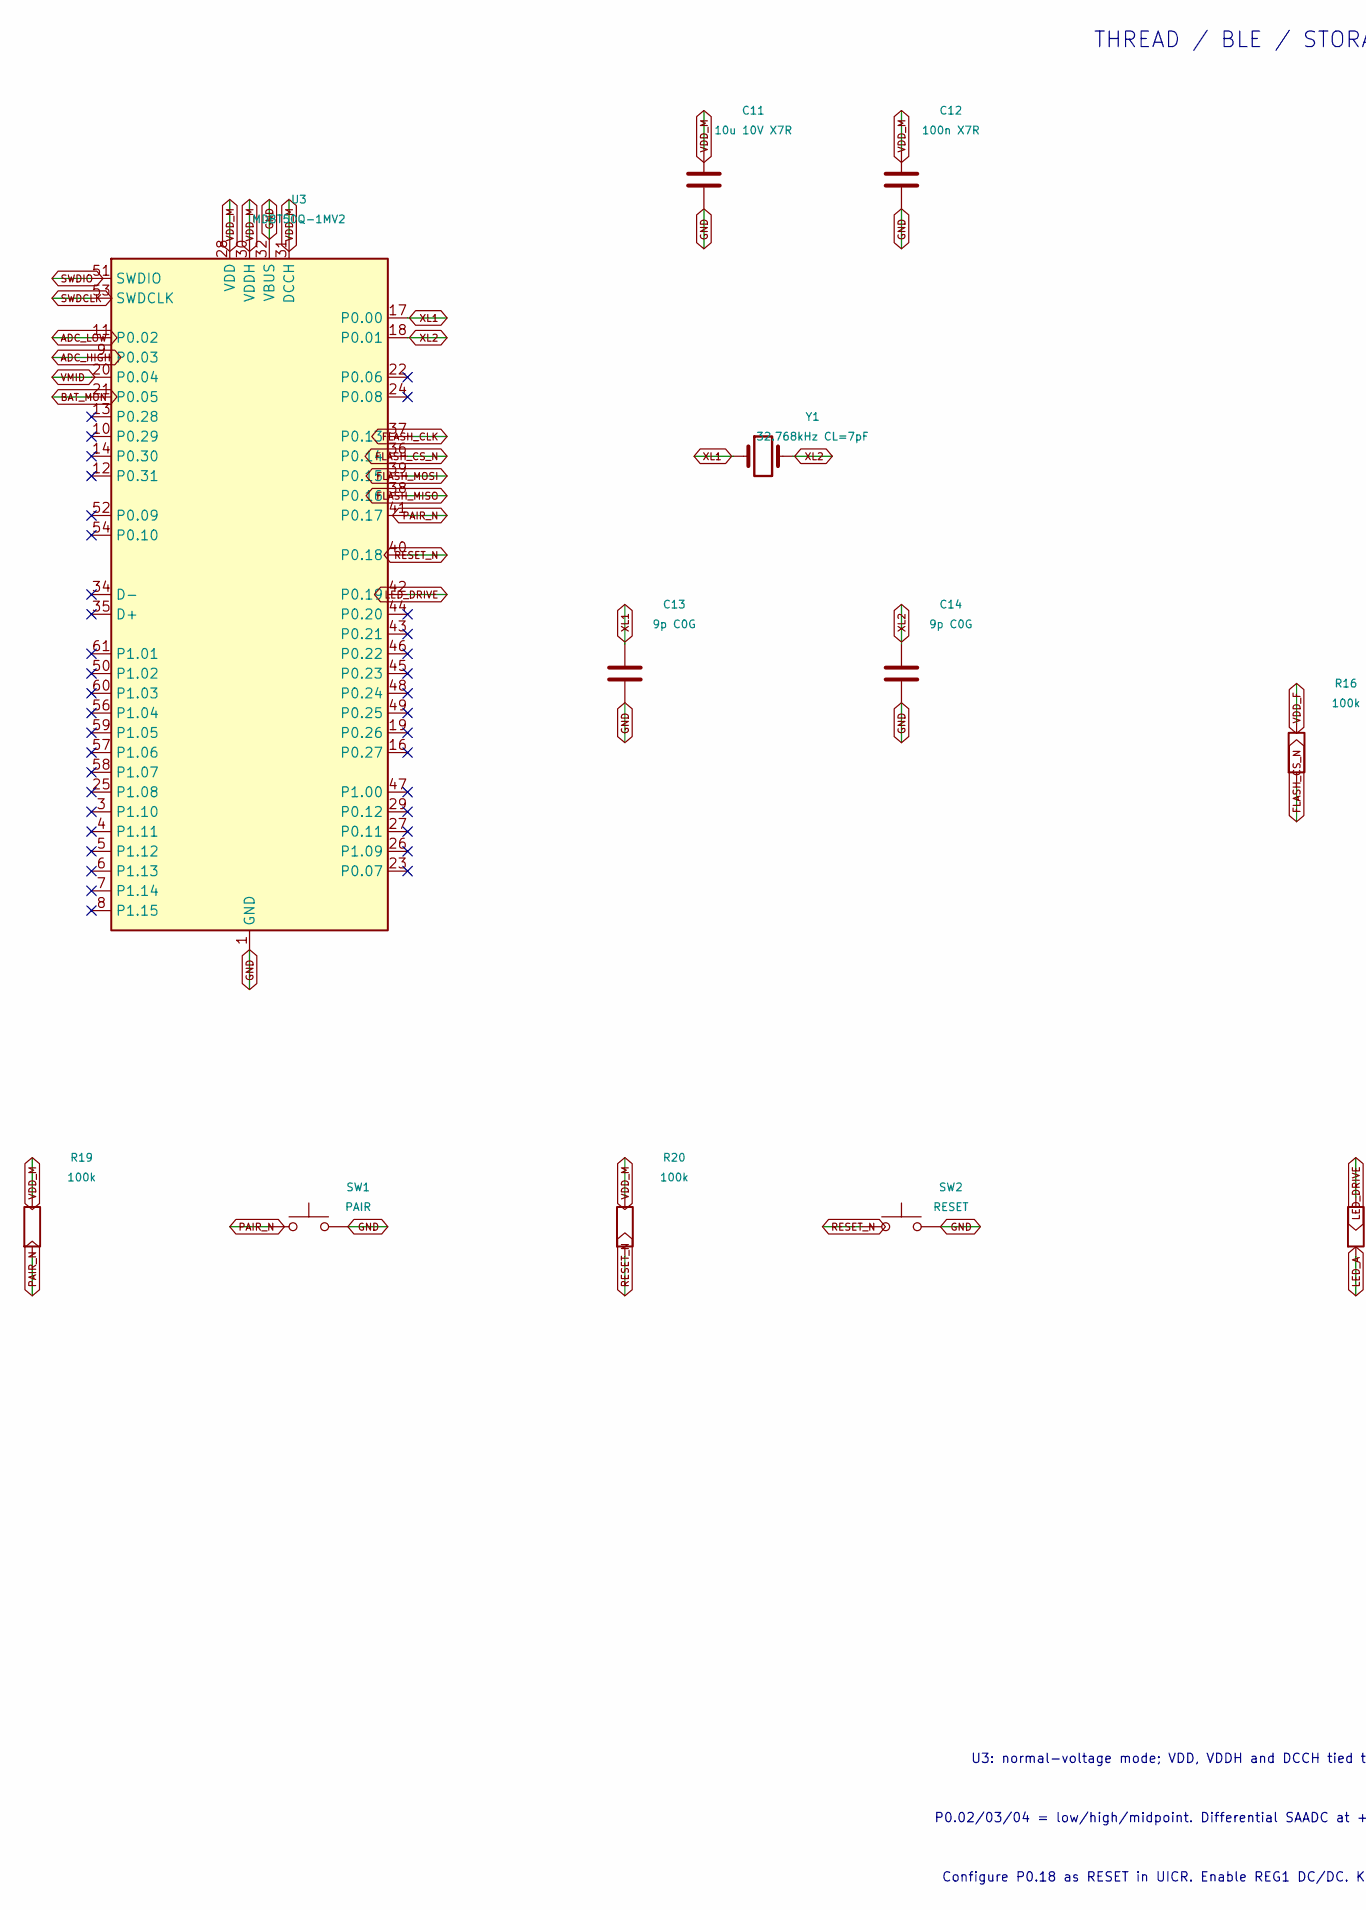
[picture p35: schematic digital.kicad_sch, Nami Compact C0 - digital, part in row 1, column 1]

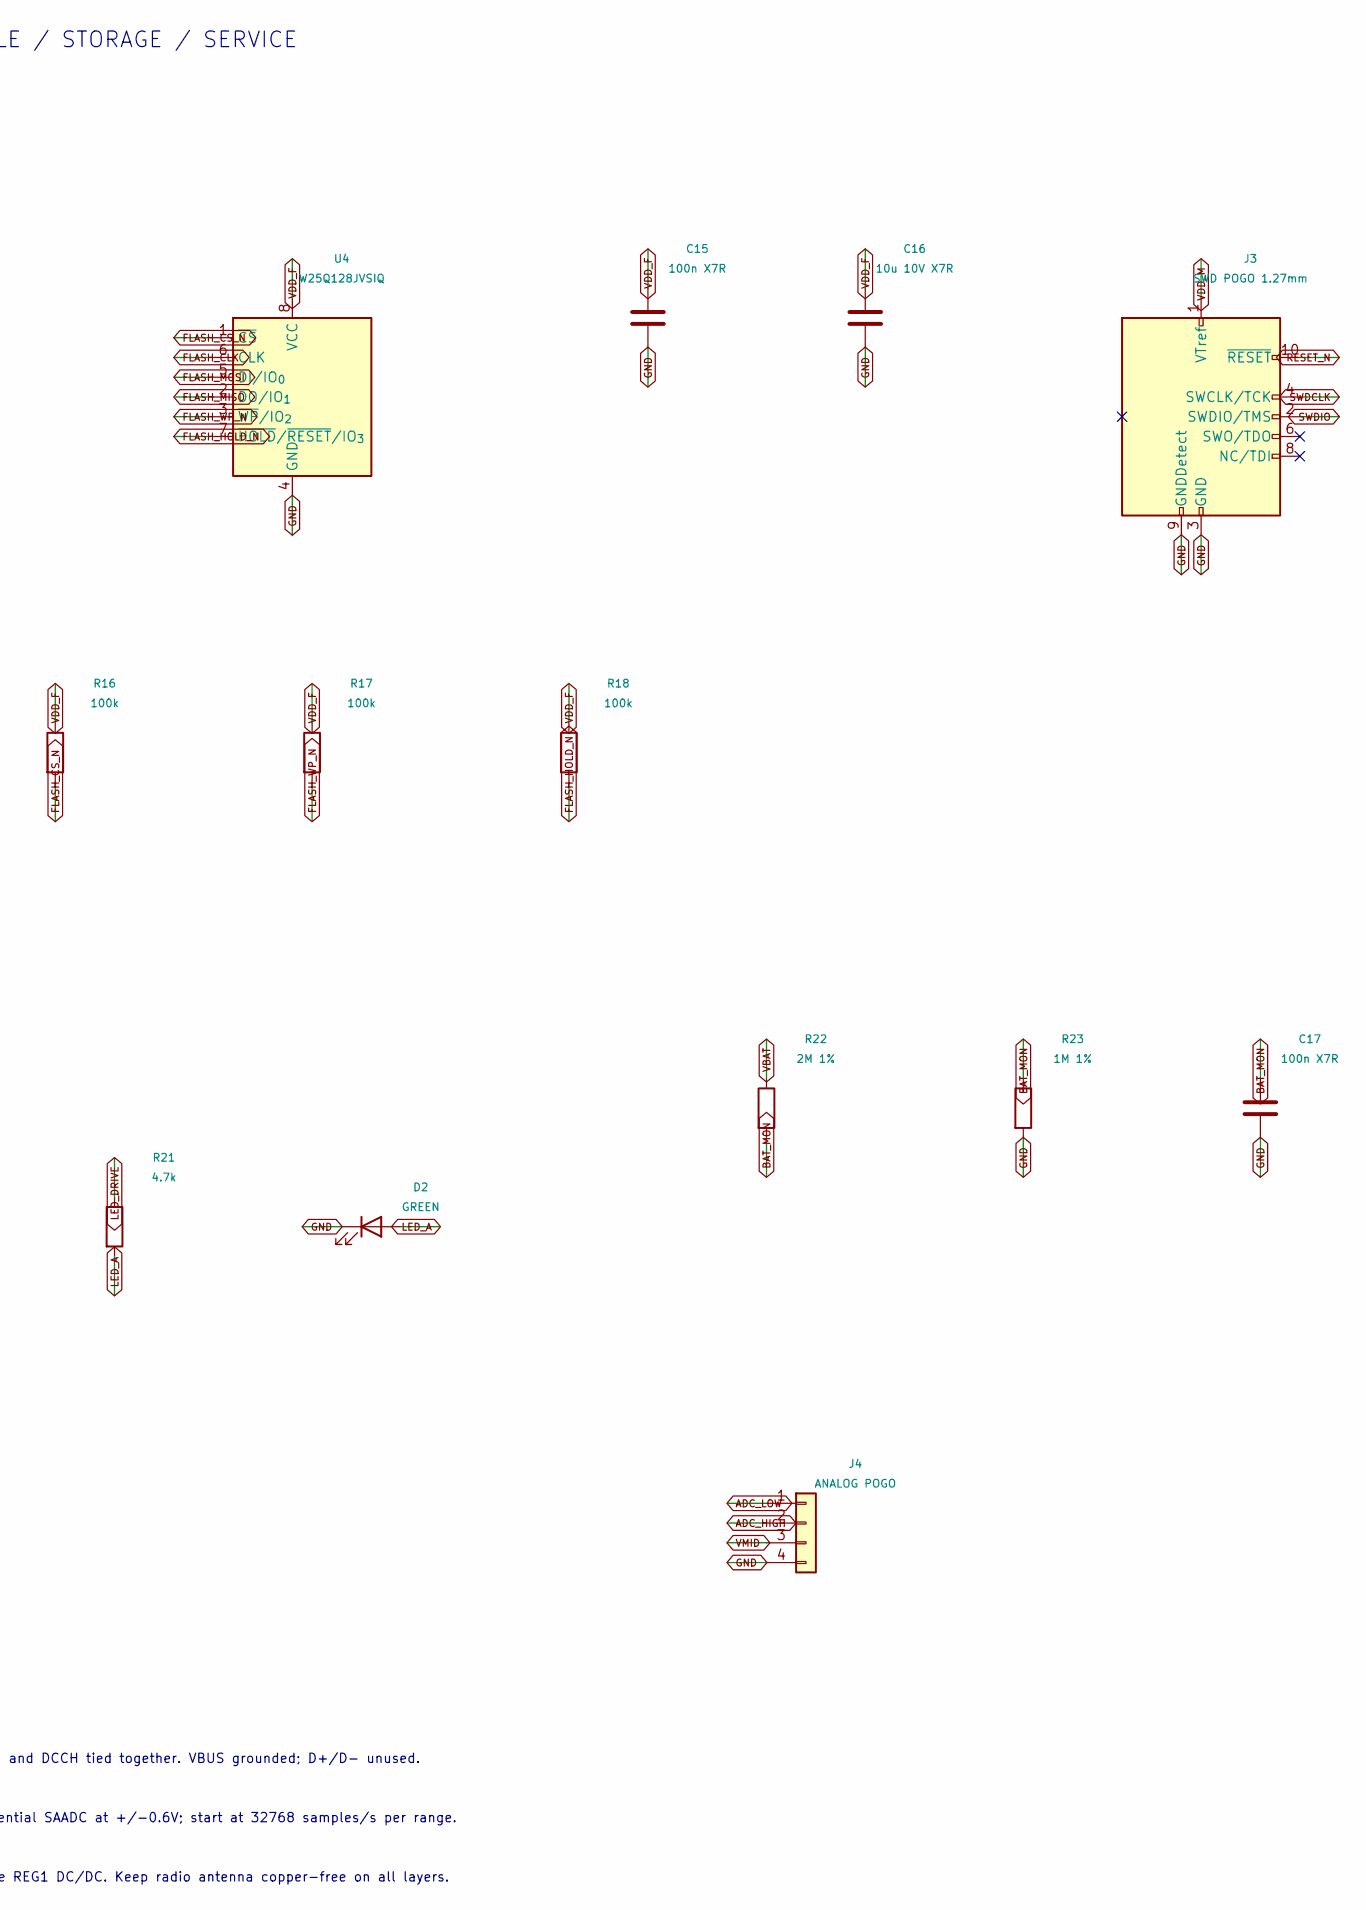
[picture p36: schematic digital.kicad_sch, Nami Compact C0 - digital, part in row 1, column 2]

Parts:
C11, C16: 10u 10V X7R; C_0805_2012Metric
C12, C15, C17: 100n X7R; C_0603_1608Metric
C13, C14: 9p C0G; C_0603_1608Metric
D2: GREEN; LED_0603_1608Metric
J3: SWD POGO 1.27mm; Pogo_2x05_P1.27
J4: ANALOG POGO; Pogo_1x04_P1.27
R16, R17, R18, R19, R20: 100k; R_0603_1608Metric
R21: 4.7k; R_0603_1608Metric
R22: 2M 1%; R_0603_1608Metric
R23: 1M 1%; R_0603_1608Metric
SW1: PAIR; SW_SPST_B3U-1000P; MPN B3U-1000P
SW2: RESET; SW_SPST_B3U-1000P; MPN B3U-1000P
U3: MDBT50Q-1MV2; Raytac_MDBT50Q; MPN MDBT50Q-1MV2
U4: W25Q128JVSIQ; SOIC-8_5.3x5.3mm_P1.27mm; MPN W25Q128JVSIQ
Y1: 32.768kHz CL=7pF; Crystal_SMD_3215-2Pin_3.2x1.5mm; MPN ABS07-32.768KHZ-7-T

Connections:
ADC_HIGH: J4.2, U3.9 (P0.03); also elsewhere on the board
ADC_LOW: J4.1, U3.11 (P0.02); also elsewhere on the board
BAT_MON: C17.1, R22.2, R23.1, U3.21 (P0.05)
FLASH_CLK: U3.37 (P0.13), U4.6 (CLK)
FLASH_CS_N: R16.2, U3.36 (P0.14), U4.1 (~CS)
FLASH_HOLD_N: R18.2, U4.7 (~HOLD/~RESET/IO_{3})
FLASH_MISO: U3.38 (P0.16), U4.2 (DO/IO_{1})
FLASH_MOSI: U3.39 (P0.15), U4.5 (DI/IO_{0})
FLASH_WP_N: R17.2, U4.3 (~WP/IO_{2})
GND: C11.2, C12.2, C13.2, C14.2, C15.2, C16.2, C17.2, D2.1 (K), J3.3 (GND), J3.5 (GND), J3.9 (GNDDetect), J4.4, R23.2, SW1.2, SW2.2, U3.1 (GND), U3.2 (GND), U3.15 (GND), U3.32 (VBUS), U3.33 (GND), U3.55 (GND), U4.4 (GND); also elsewhere on the board
LED_A: D2.2 (A), R21.2
LED_DRIVE: R21.1, U3.42 (P0.19)
PAIR_N: R19.2, SW1.1, U3.41 (P0.17)
RESET_N: J3.10 (~RESET), R20.2, SW2.1, U3.40 (P0.18)
SWDCLK: J3.4 (SWCLK/TCK), U3.53 (SWDCLK)
SWDIO: J3.2 (SWDIO/TMS), U3.51 (SWDIO)
VBAT: R22.1; also elsewhere on the board
VDD_F: C15.1, C16.1, R16.1, R17.1, R18.1, U4.8 (VCC); also elsewhere on the board
VDD_M: C11.1, C12.1, J3.1 (VTref), R19.1, R20.1, U3.28 (VDD), U3.30 (VDDH), U3.31 (DCCH); also elsewhere on the board
VMID: J4.3, U3.20 (P0.04); also elsewhere on the board
XL1: C13.1, U3.17 (P0.00), Y1.1
XL2: C14.1, U3.18 (P0.01), Y1.2

Notes on the sheet:
THREAD / BLE / STORAGE / SERVICE
U3: normal-voltage mode; VDD, VDDH and DCCH tied together. VBUS grounded; D+/D- unused.
P0.02/03/04 = low/high/midpoint. Differential SAADC at +/-0.6V; start at 32768 samples/s per range.
Configure P0.18 as RESET in UICR. Enable REG1 DC/DC. Keep radio antenna copper-free on all layers.

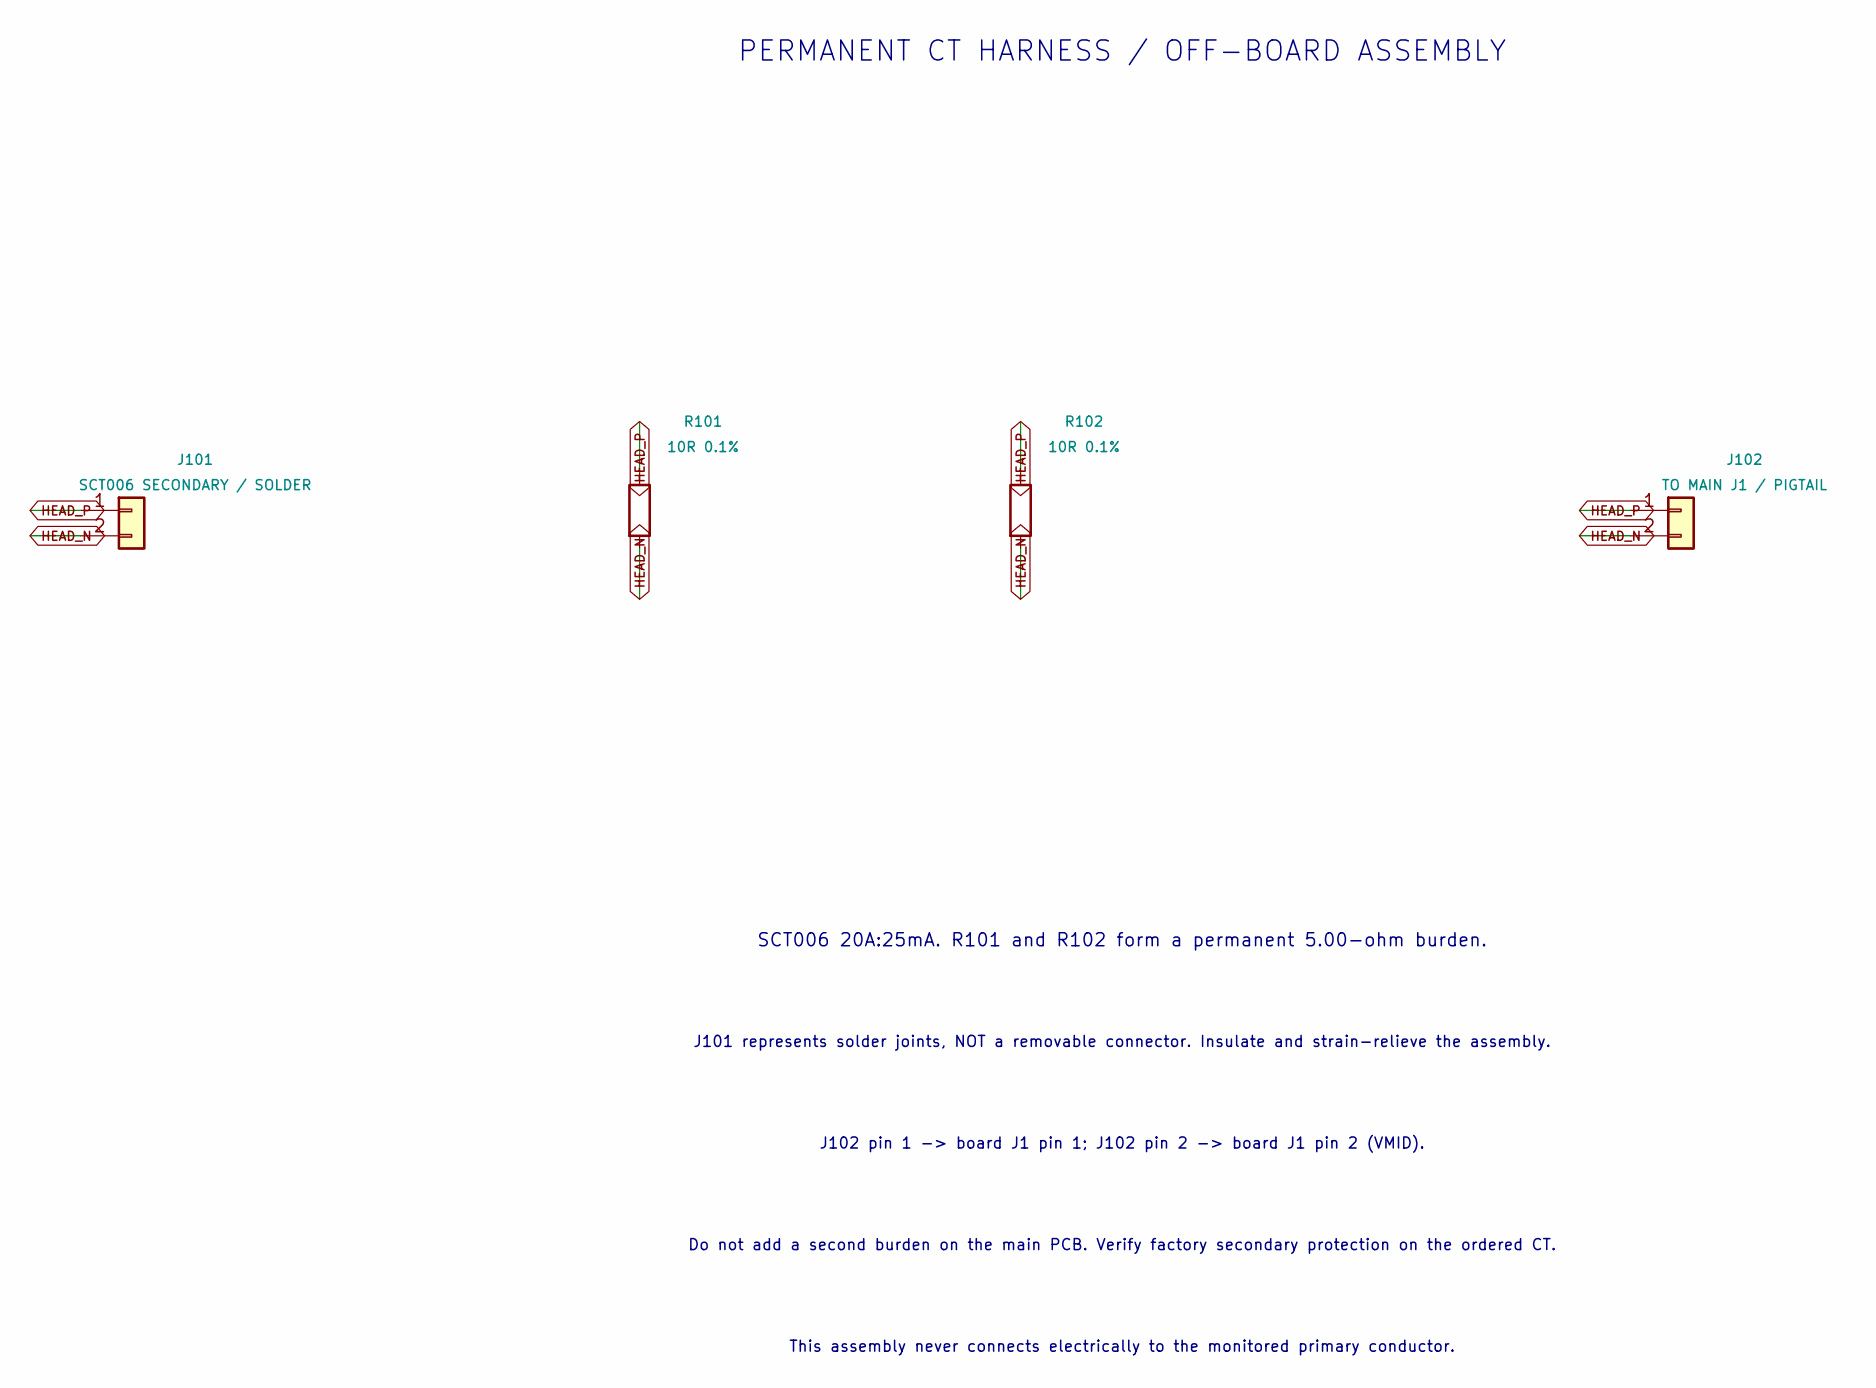
[picture p37: schematic harness.kicad_sch, Nami Compact C0 - harness]

Parts:
J101: SCT006 SECONDARY / SOLDER; PinHeader_1x02_P2.54mm_Vertical
J102: TO MAIN J1 / PIGTAIL; PinHeader_1x02_P2.54mm_Vertical
R101, R102: 10R 0.1%; R_0805_2012Metric

Connections:
unnamed: J101.1, J102.1, R101.1, R102.1
unnamed: J101.2, J102.2, R101.2, R102.2

Notes on the sheet:
PERMANENT CT HARNESS / OFF-BOARD ASSEMBLY
SCT006 20A:25mA. R101 and R102 form a permanent 5.00-ohm burden.
J101 represents solder joints, NOT a removable connector. Insulate and strain-relieve the assembly.
J102 pin 1 -> board J1 pin 1; J102 pin 2 -> board J1 pin 2 (VMID).
Do not add a second burden on the main PCB. Verify factory secondary protection on the ordered CT.
This assembly never connects electrically to the monitored primary conductor.

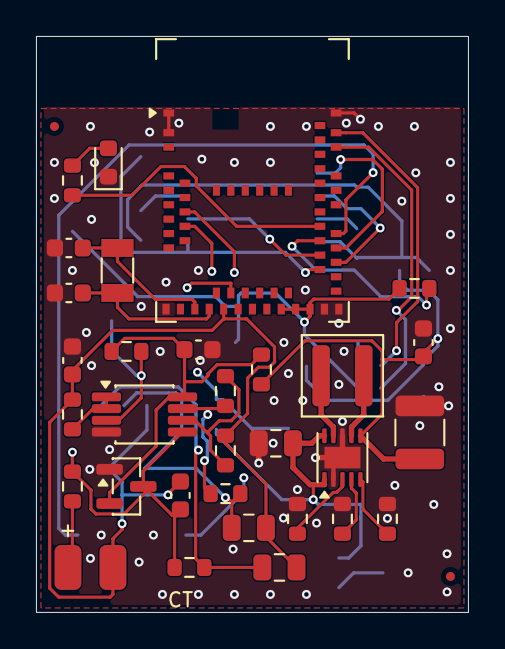
[picture p38: board nami.kicad_pcb from above]

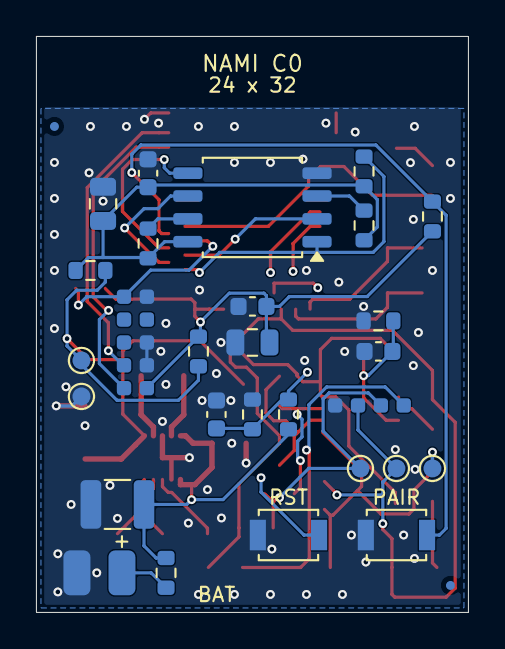
[picture p39: board nami.kicad_pcb from below]

Board: 4 copper layers, 24.0 x 32.0 mm, 63 parts (30 on the bottom side), 36 nets.

Other parts of the board:
FID1, FID2, FID3, FID4: Fiducial_0.5mm_Mask1mm
