jemdiggity/nami/(commit log)

2026-09-26 Document Nami prototype requirements and system architecture
2026-09-26 Add Nami Rev A KiCad bench hardware design
    [analog.kicad_sch, bom.csv, digital.kicad_sch, harness.kicad_sch, nami.kicad_pcb, nami.kicad_sch, power.kicad_sch]
2026-09-26 Add 24 by 32 mm compact Nami production layout candidate
    [analog.kicad_sch, bom.csv, digital.kicad_sch, harness.kicad_sch, nami-compact.step, nami.kicad_pcb, nami.kicad_sch, power.kicad_sch]
2026-09-26 Refine compact routing and draw wired analog schematics
    [analog.kicad_sch, nami-compact.step, nami.kicad_pcb]
2026-09-26 Add vector schematics and PCB previews to README
2026-09-26 Add 3D PCB preview linked to interactive STL model
    [nami-compact.stl]
